Debrant/great_411_practicum/images/AHSmatrix.jpg

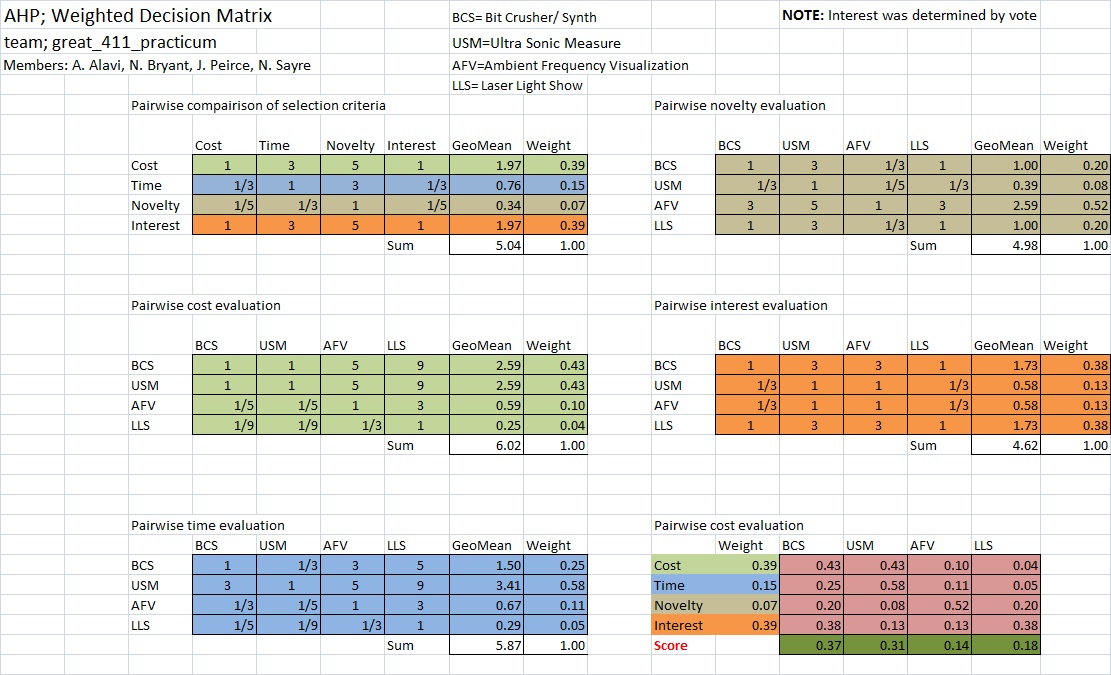
images/AHSmatrix.jpg
