Debrant/great_411_practicum/images/Relation_diagram.jpg

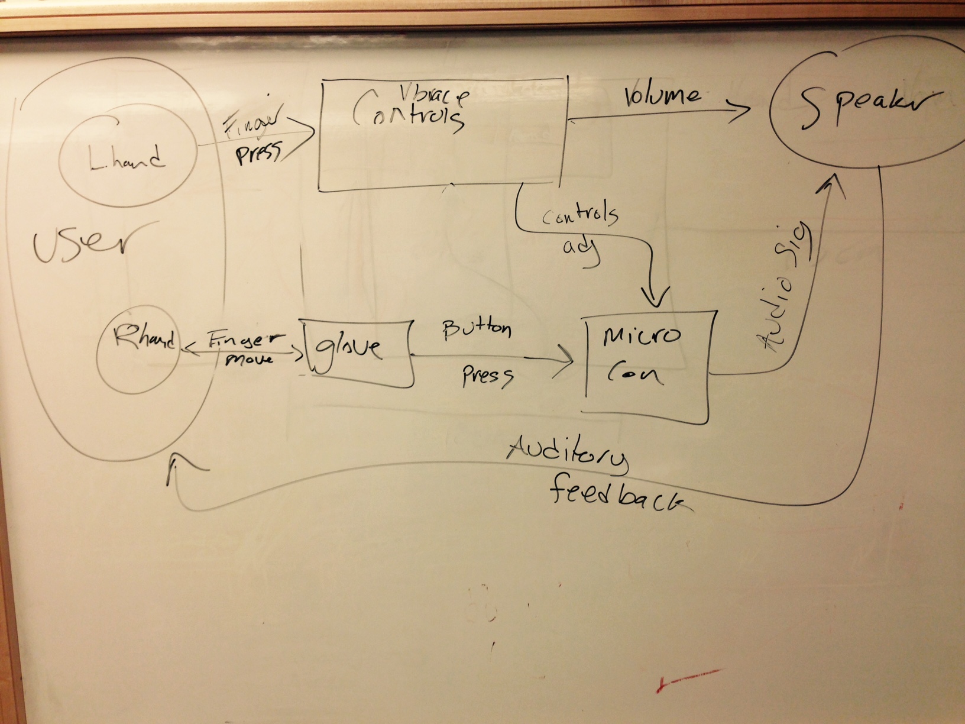
images/Relation_diagram.jpg
