Debrant/great_411_practicum/README.md

great_411_practicum
===================

Fall 2014 Industry Design Practicum at PSU

#[Project Wiki](https://github.com/Debrant/great_411_practicum/wiki)
