Debrant/great_411_practicum/pdfs/presentation.pdf

T01

# Synthesizer Glove

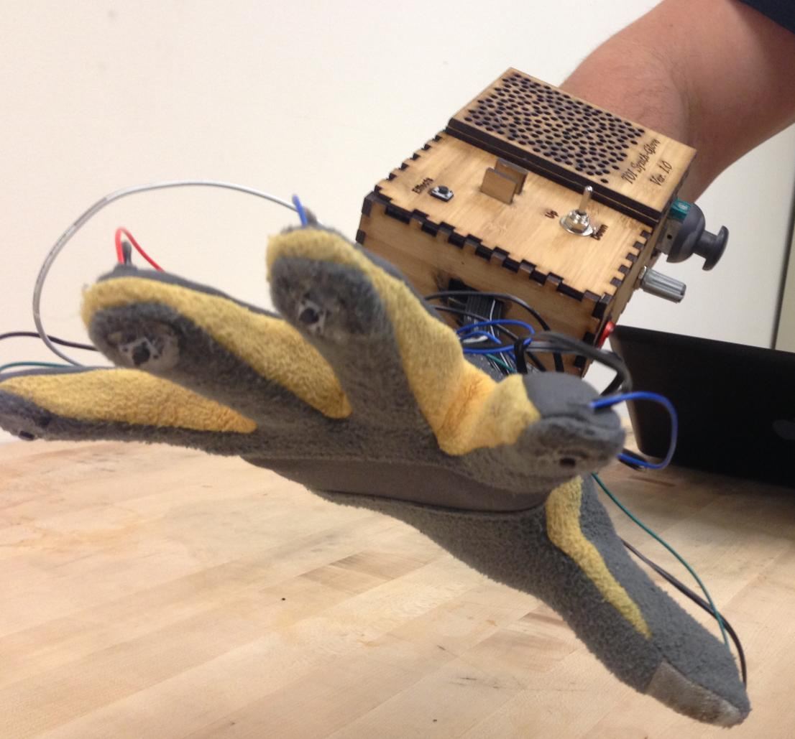
[picture p3: figure]

## Steve Peirce Nicholas Sayre Nathan Bryant Ali Alavi

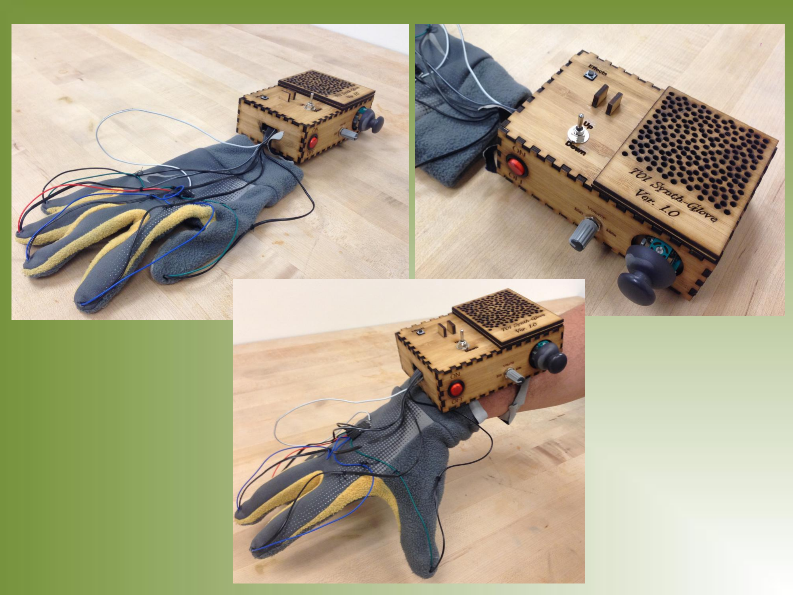
[picture p4: page 2]

# Motive

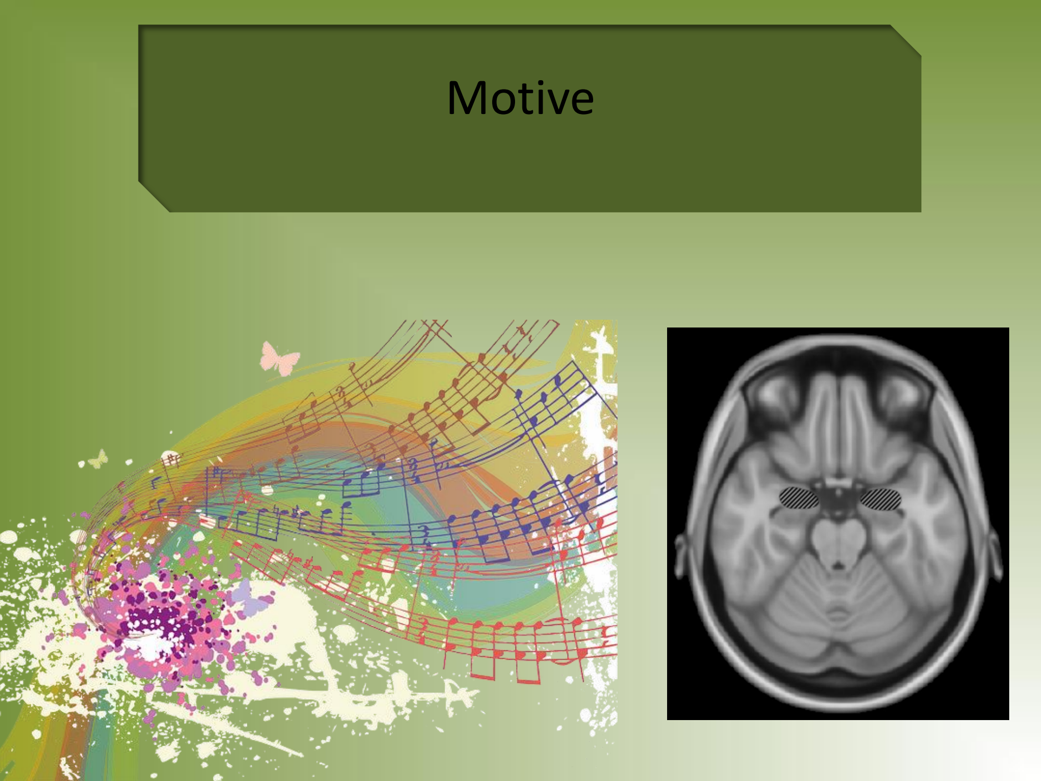
[picture p5: page 3]

# Goal

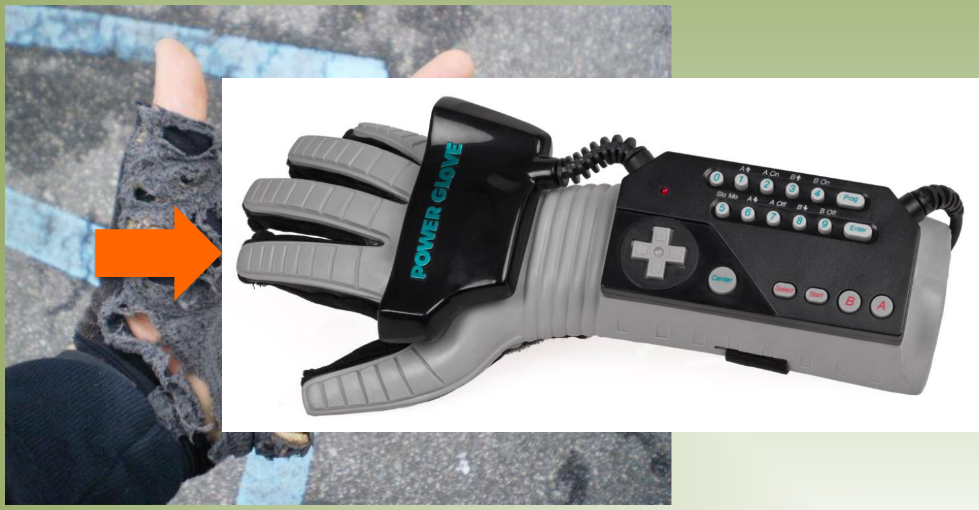
[picture p6: figure]

# Alternatives

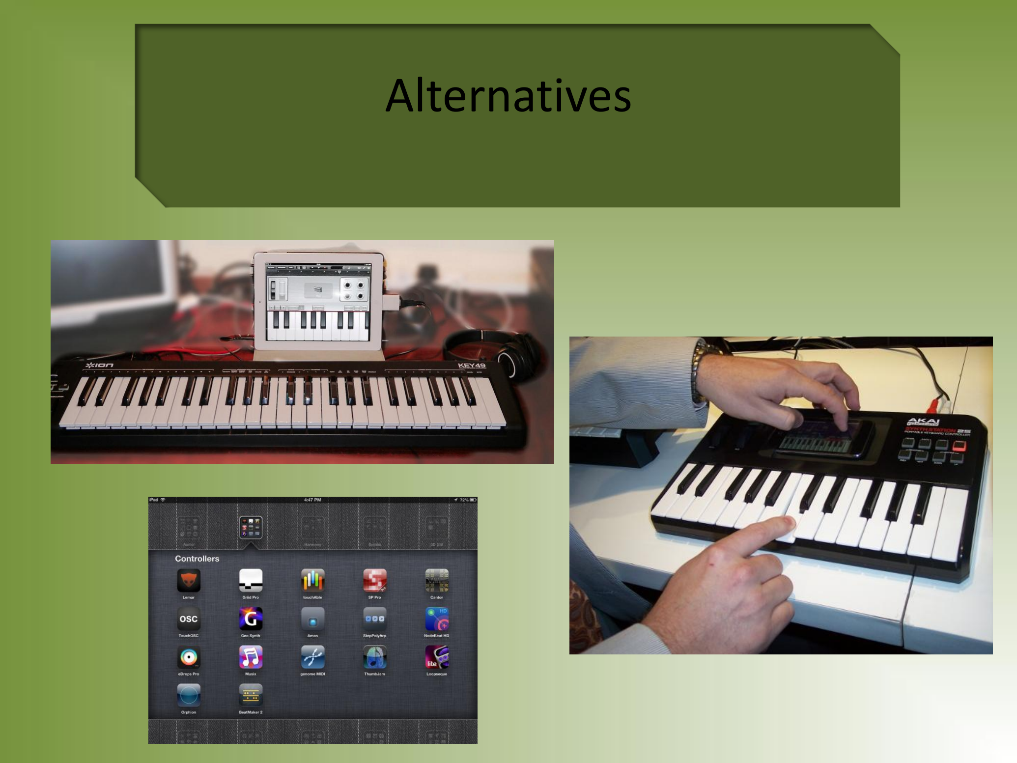
[picture p7: page 5]

# Approach

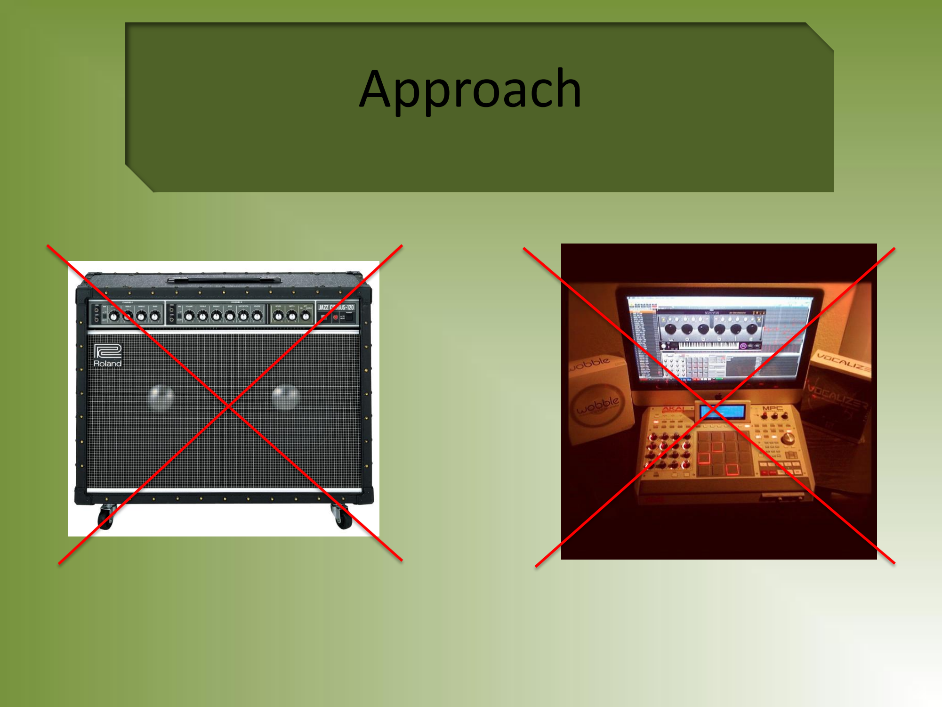
[picture p8: page 6]

# Requirements

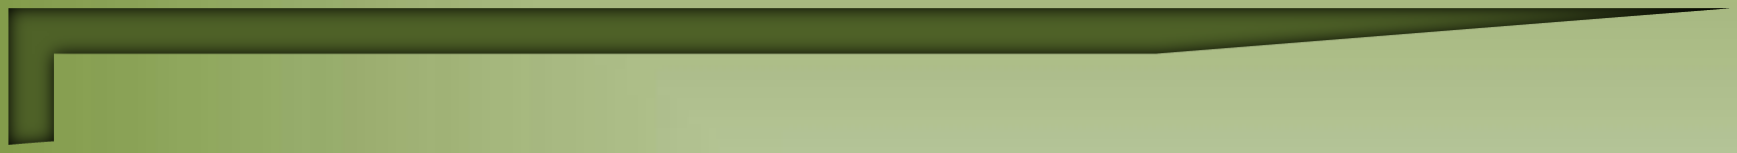
[picture p9: figure]

# System will be capable of producing tones

based on finger contact.

# System will be capable of producing a

minimum of 5 frequencies.

# System will be capable of altering the produced tones based on the status of at least two

sensors.

# The system will use an inexpensive cost microcontroller to produce low resolution

sounds.

# System must be wearable on users hand or

forearm.

# System will be battery powered and have power consumption of approximately 2.5

watts.

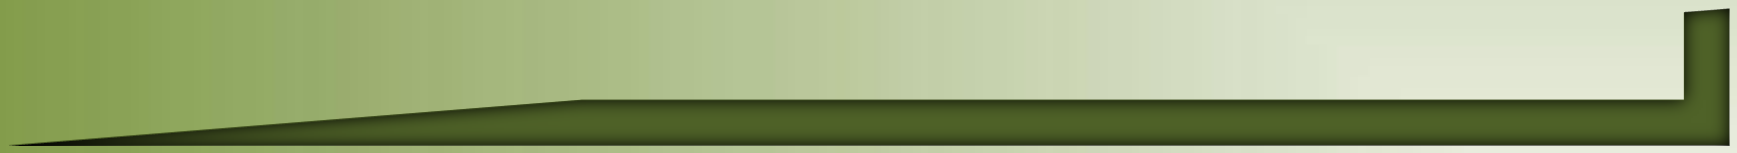
[picture p10: figure]

# Design Level 0

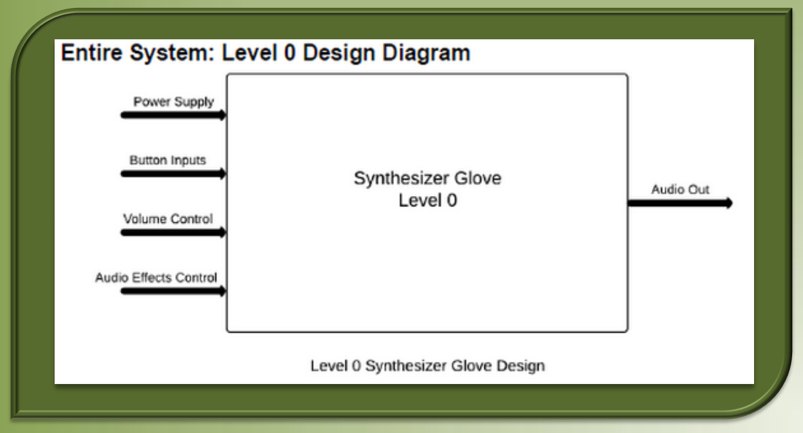
[picture p11: figure]

# Design Level 1

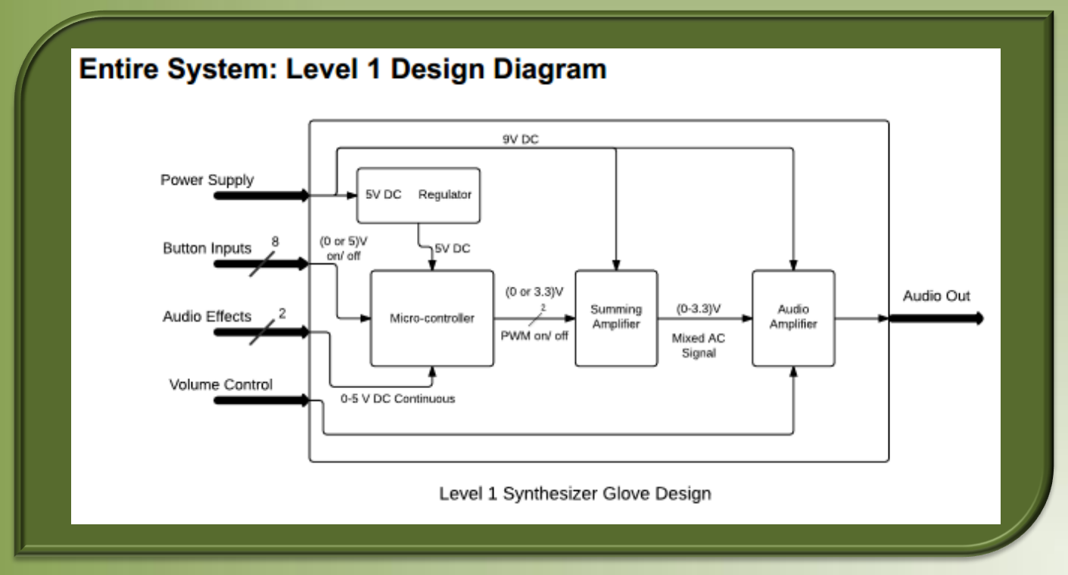
[picture p12: figure]

# Use Case

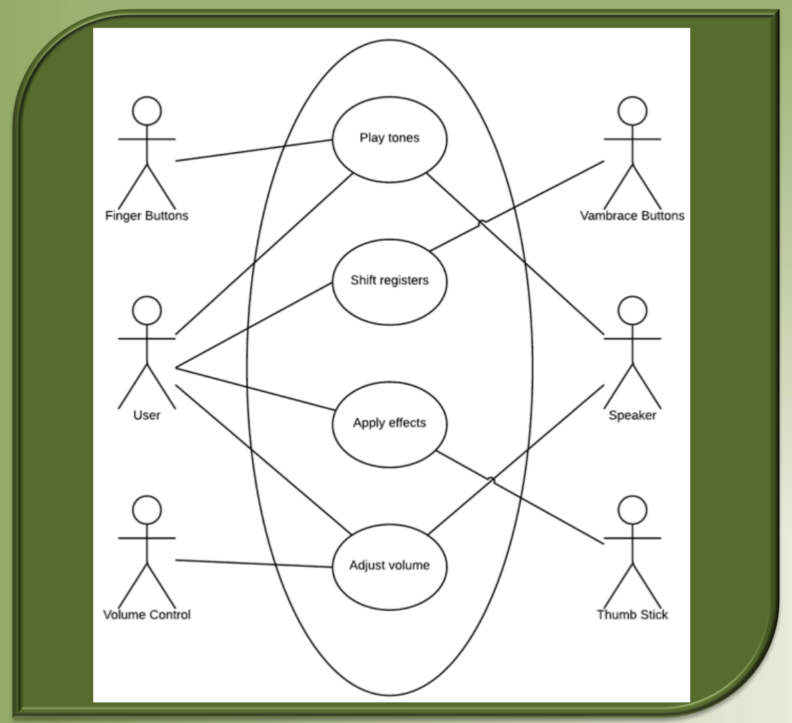
[picture p13: figure]

# Schematic

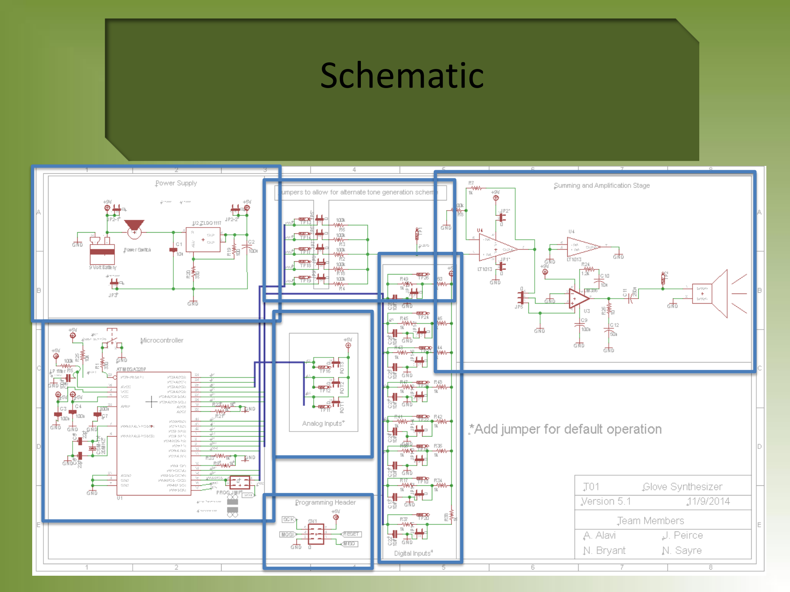
[picture p14: page 11]

# PCB Layout

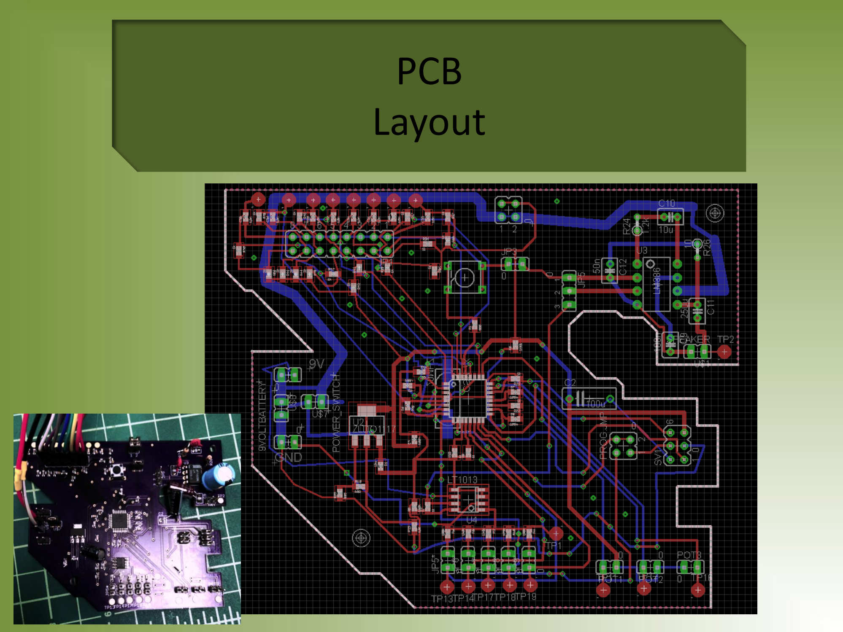
[picture p15: page 12]

# Programming

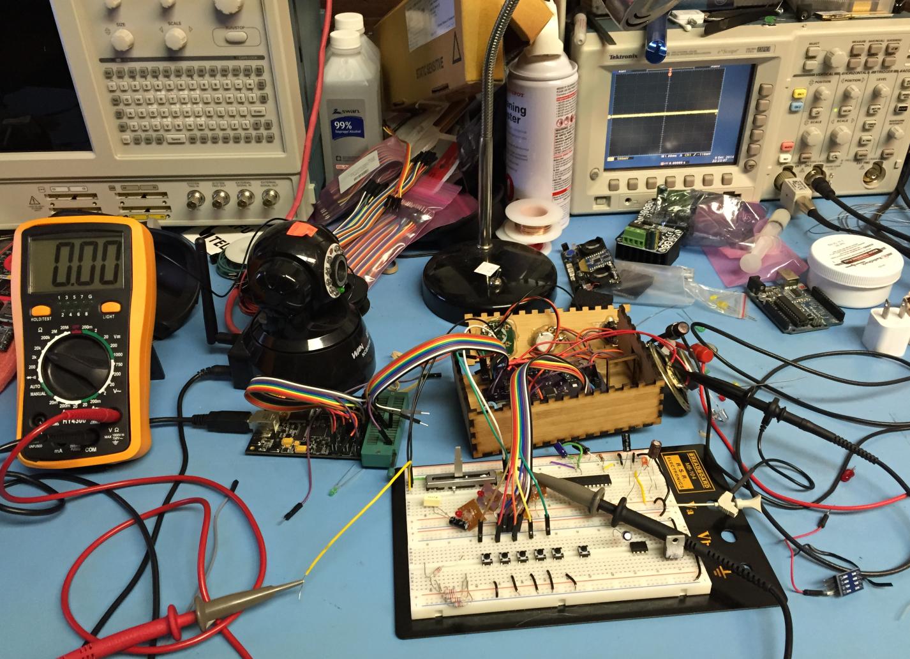
[picture p16: figure]

# Programming Testing

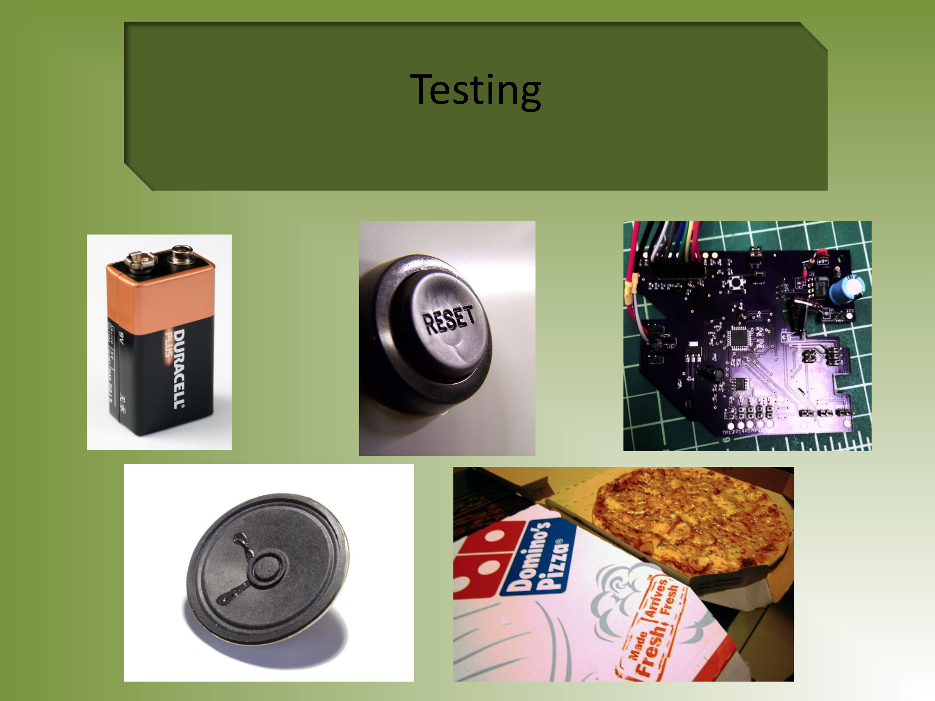
[picture p17: page 14]

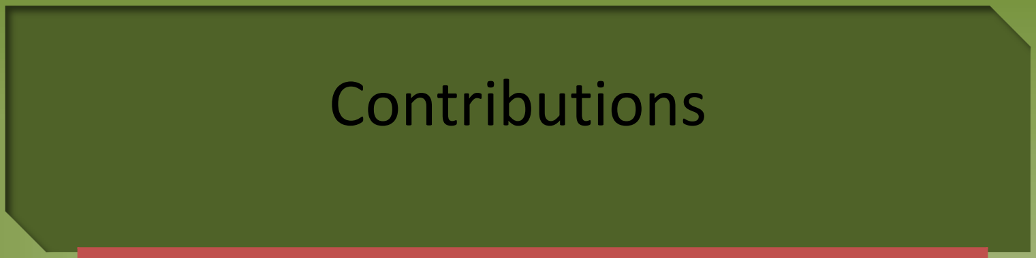
[picture p18: figure]
Contributions

Ali | Nathan | Nick | Steve
Research | Research | Research | Research
Proposal | Proposal | Proposal | Proposal
Design Requirements | Design Requirements | Design Requirements | Test Programs
Prototype Board Assembly | Schematic | Schematic | Write Program
Project Schedule Draft+Revise | PCB Layout | PCB Layout | Revise Program
System Diagrams | Project Schedule Review | Prototype Board Design and Assembly | Finalize Program
Housing | System Diagrams | System Diagrams | Testing
Prototype Assembly | Test Plan | Housing
Testing | Housing | PCB assembly
Presentation | PCB assembly | Prototype Assembly
| Prototype Assembly | Testing
| Testing

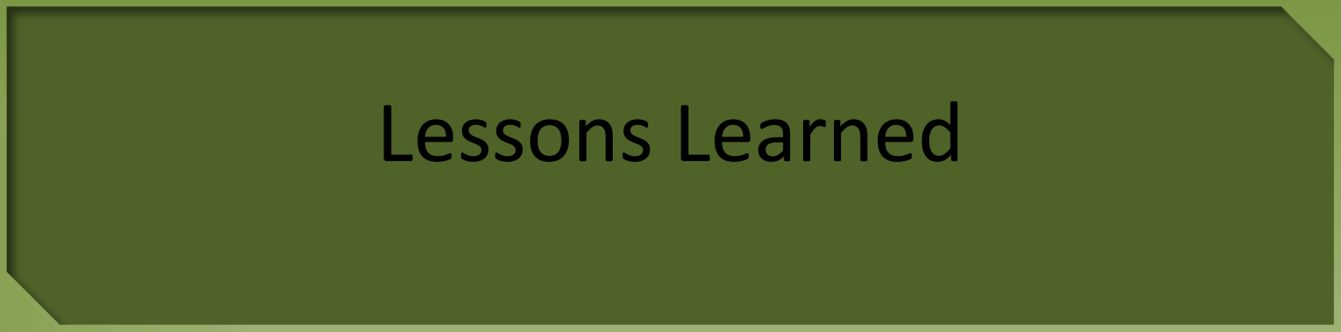
[picture p19: figure]
Lessons Learned

## - RULE OF 10!

-The ugly truth of Murphy's Law.

## -Eagle -Board layouts -Research research research! -Reading data sheets closely and repeatedly is key -Teamwork can be rough… -Stay ahead of schedule!

# Intellectual Property

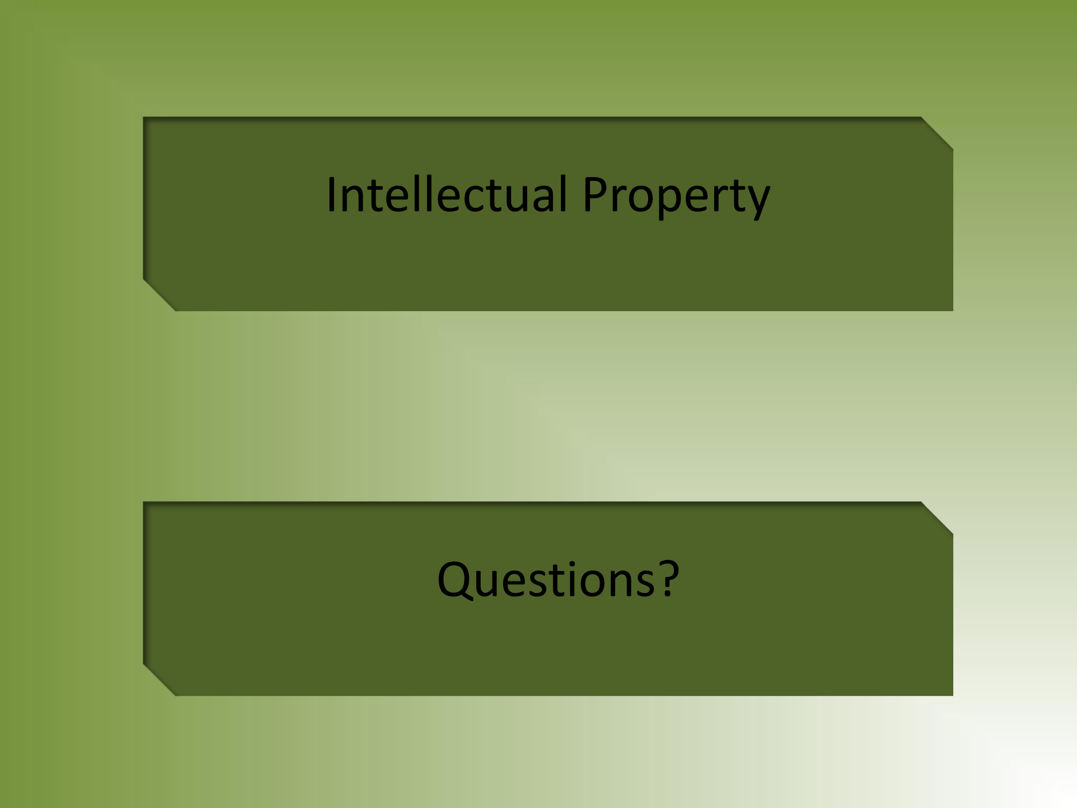
[picture p20: page 17]

# Questions?
