Debrant/great_411_practicum/pdfs/JRC 2073 low voltage audio amplifier.pdf

# NJM2073

# MEMO

[CAUTION]
The specifications on this databook are only given for information , without any guarantee as regards either mistakes or omissions. The application circuits in this databook are described only to show representative usages of the product and not intended for the guarantee or permission of any right including the industrial rights.
