Debrant/great_411_practicum/Schedule/joj_sched1_short.pdf

ID | Task Name
0 | T01 Synthesizer Glove
1 | 1 Choose Project
6 | 2 Research
19 | 3 Project Proposal
25 | 4 Manage Project Wiki
26 | 5 Design Requirements
32 | 6 Preliminary Schematic
41 | 7 Wire glove with buttons
42 | 8 Preliminary Board Layout
S | T | T | S | F | W | M | S
Sep 28, '14 | Oct 12, '14 | Oct 26, '14

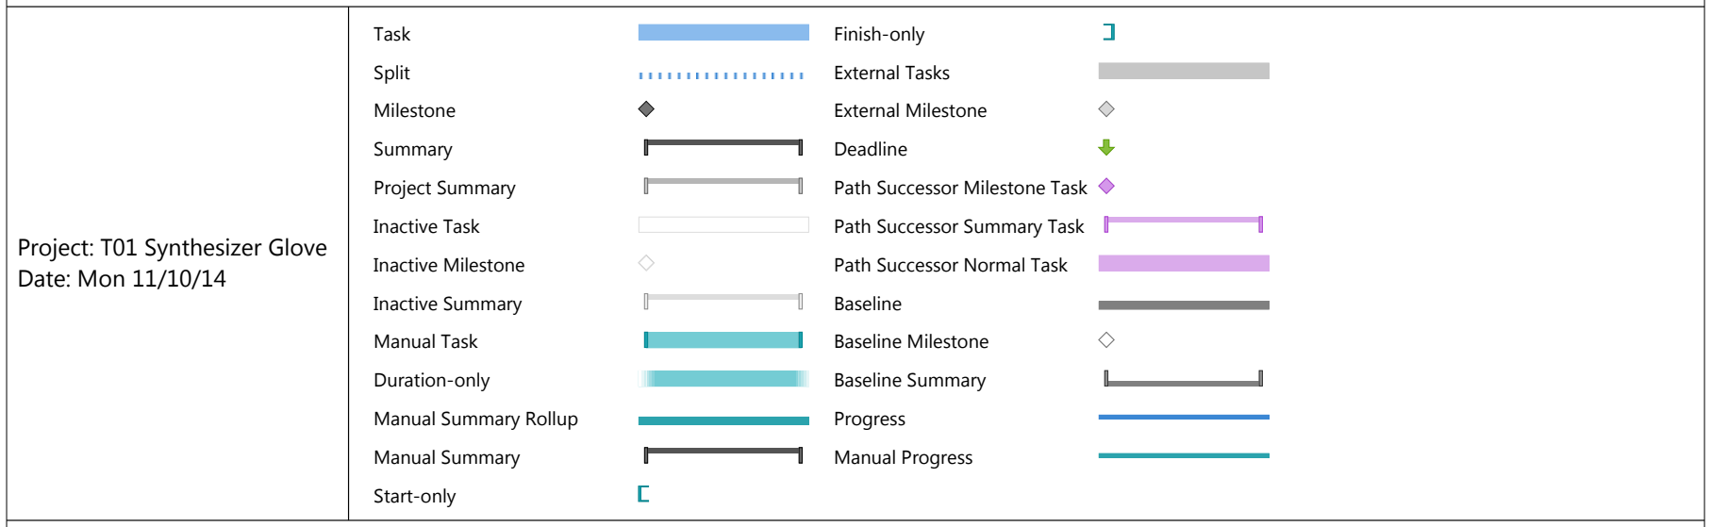
[picture p30: figure]
Task; Split; Milestone; Summary; Project Summary; Inactive Task; Inactive Milestone; Inactive Summary; Manual Task; Duration-only; Manual Summary Rollup; Manual Summary; Start-only; Finish-only; External Tasks; External Milestone; Deadline; Path Successor Milestone Task; Path Successor Summary Task; Path Successor Normal Task; Baseline; Baseline Milestone; Baseline Summary; Progress; Manual Progress; Project: T01 Synthesizer Glove Date: Mon 11/10/14

ID | Task Name
49 | 9 Prototype Board
58 | 10 Project Schedule
66 | 11 Send PCB files to vendor
73 | 12 System Diagram
81 | 13 Program Microcontroller
92 | 14 Test Plan
96 | 15 Build Housing
99 | 16 Working Prototype
112 | 17 Demo
S | T | T | S | F | W | M | S
Sep 28, '14 | Oct 12, '14 | Oct 26, '14

### Nathan,Nicholas,Ali

### Nathan,Nicholas,Steve

S | T | T | S | F | W | M | S | T | T | S | F | W
Oct 26, '14 | Nov 9, '14 | Nov 23, '14 | Dec 7, '14 | Dec 21, '14

12/8

S | T | T | S | F | W | M | S | T | T | S | F | W
Oct 26, '14 | Nov 9, '14 | Nov 23, '14 | Dec 7, '14 | Dec 21, '14
