Debrant/great_411_practicum/Case_plans/bl2.png

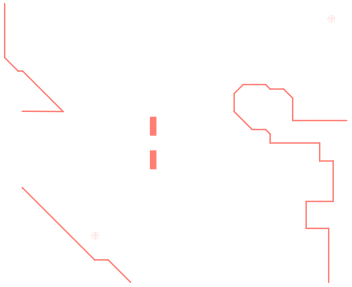
Case_plans/bl2.png
