Debrant/great_411_practicum/images/CompleteBoard.jpeg

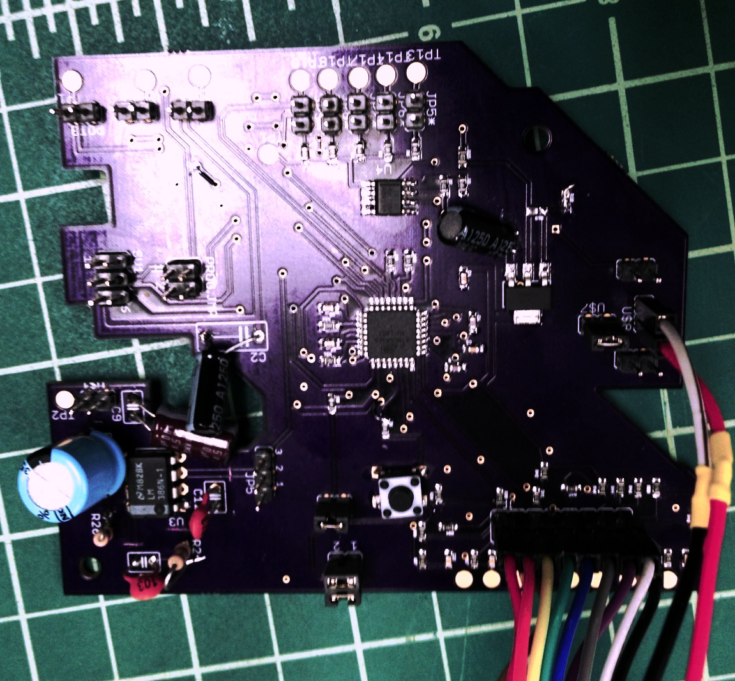
images/CompleteBoard.jpeg
