Debrant/great_411_practicum/images/FinalBRD.png

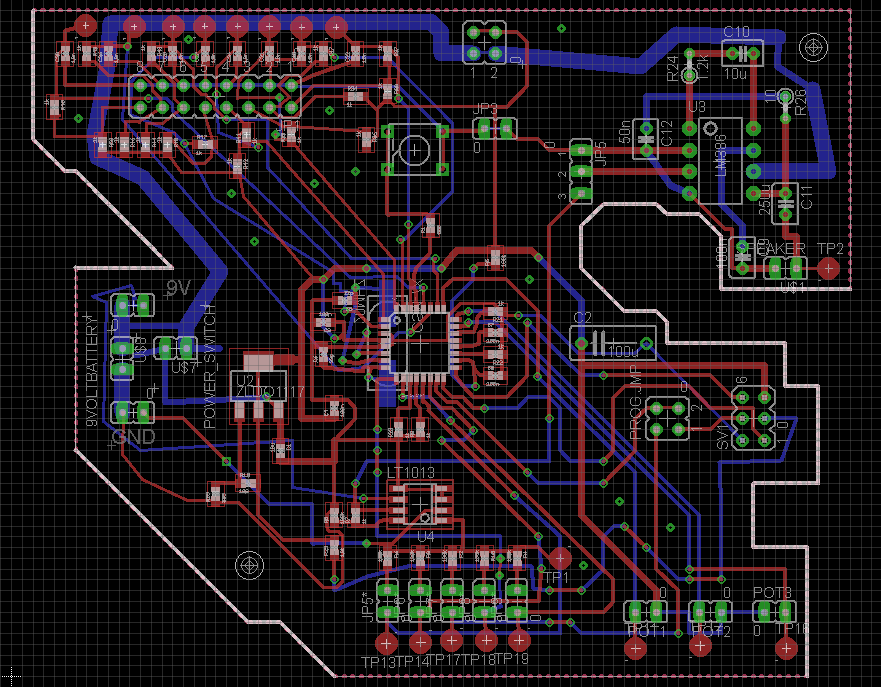
images/FinalBRD.png
