Debrant/great_411_practicum/images/FinalSCHM.png

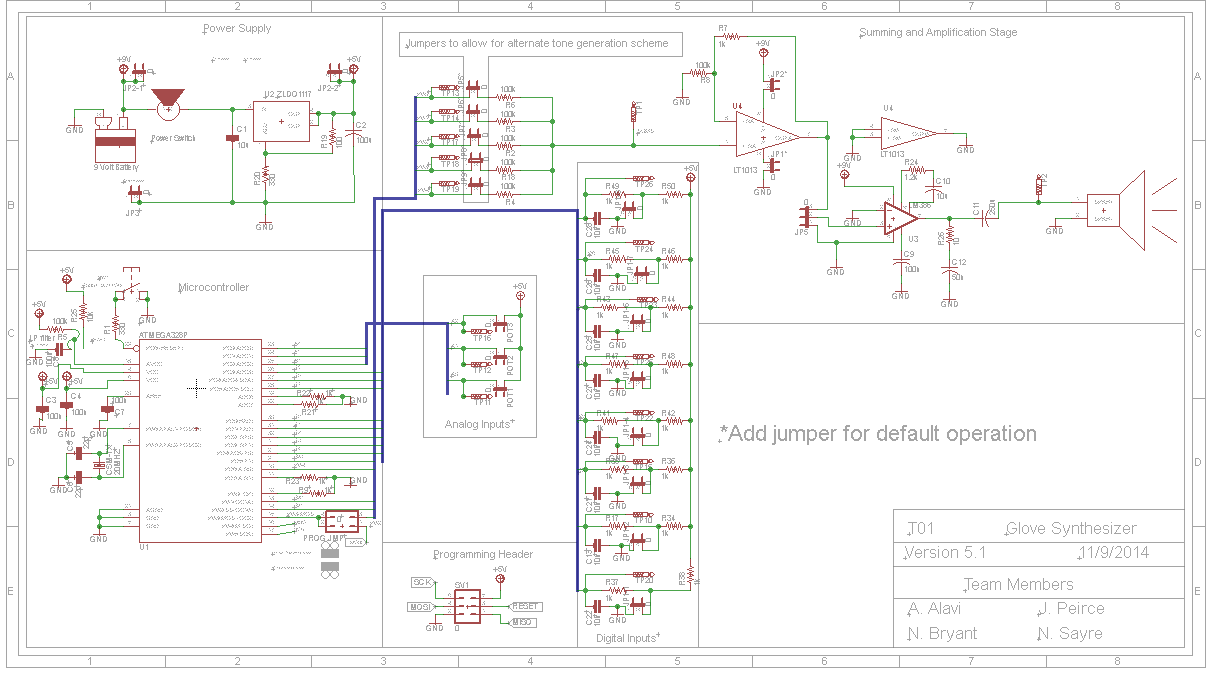
images/FinalSCHM.png
