Debrant/great_411_practicum/images/Fmap.gif

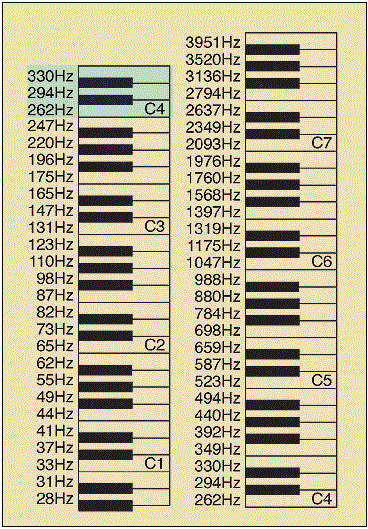
images/Fmap.gif
