Debrant/great_411_practicum/images/Lvl1_amps.jpg

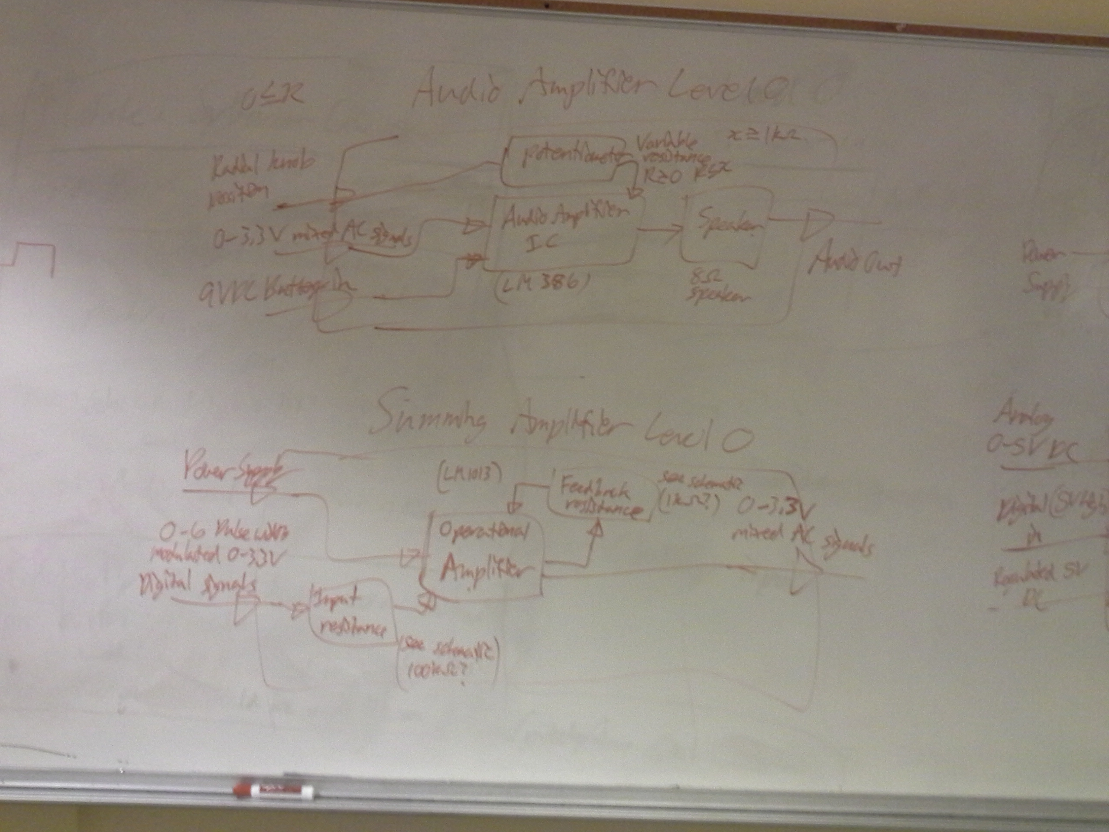
images/Lvl1_amps.jpg
