Debrant/great_411_practicum/images/Lvl1_system.jpg

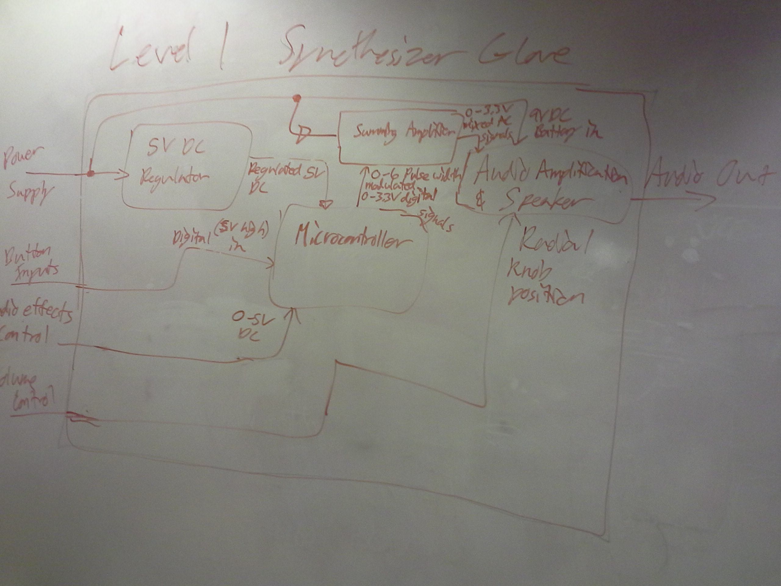
images/Lvl1_system.jpg
