Debrant/great_411_practicum/images/Lvl1_VR_MCU.jpg

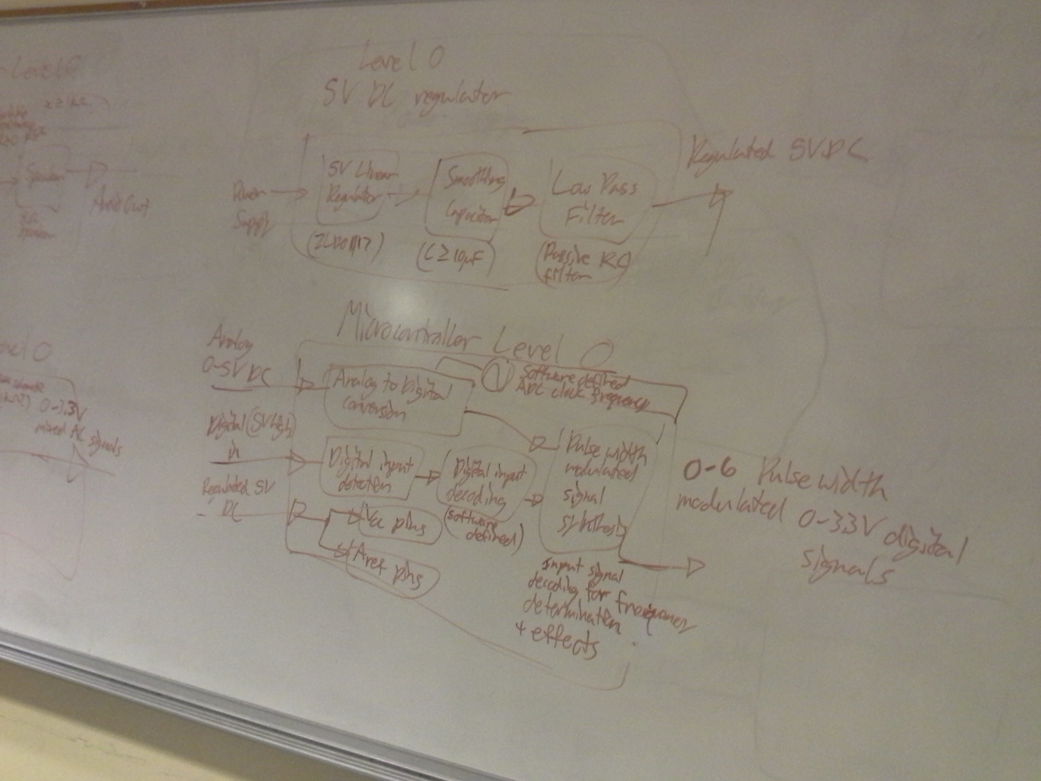
images/Lvl1_VR_MCU.jpg
