Debrant/great_411_practicum/images/meetnov9.JPG

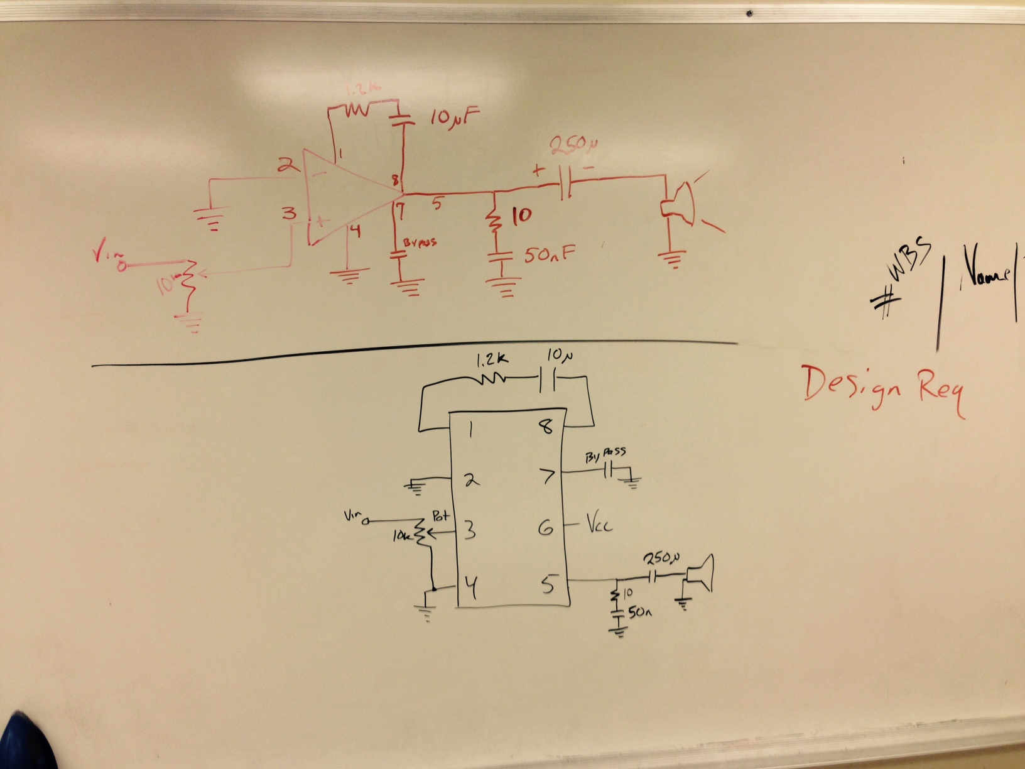
images/meetnov9.JPG
