Debrant/great_411_practicum/images/photo 1.JPG

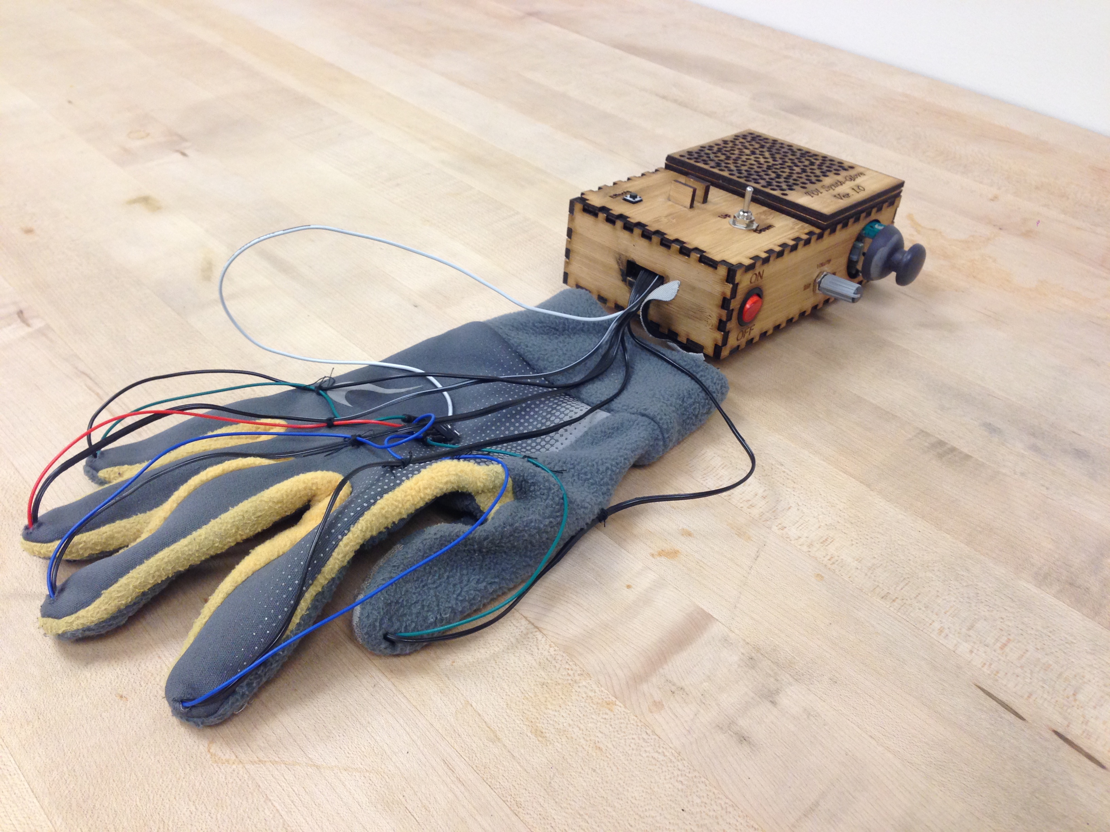
images/photo 1.JPG
