Debrant/great_411_practicum/images/photo 2.JPG

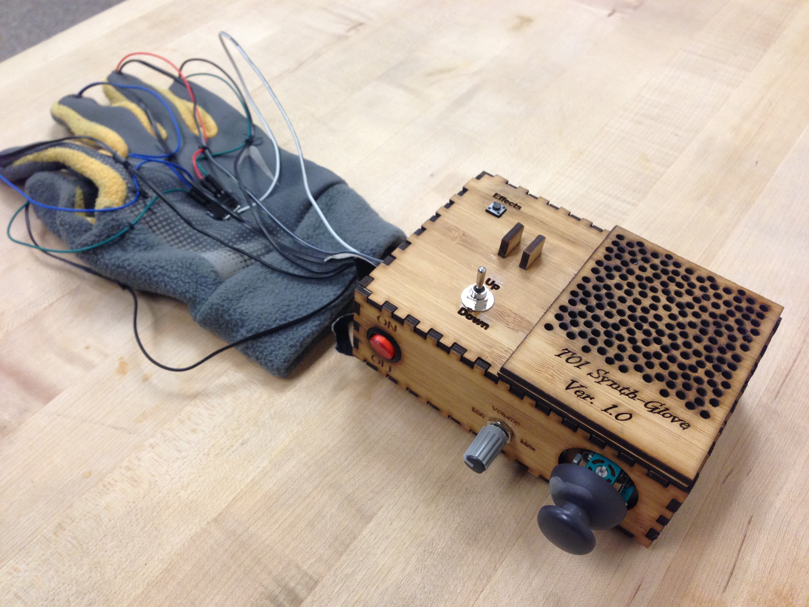
images/photo 2.JPG
