Debrant/great_411_practicum/images/photo 3.JPG

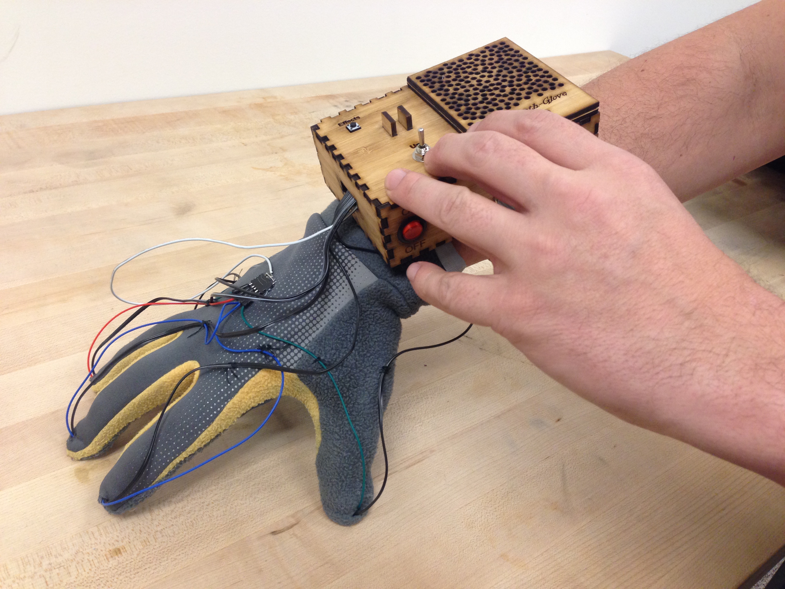
images/photo 3.JPG
