Debrant/great_411_practicum/images/photo 4.JPG

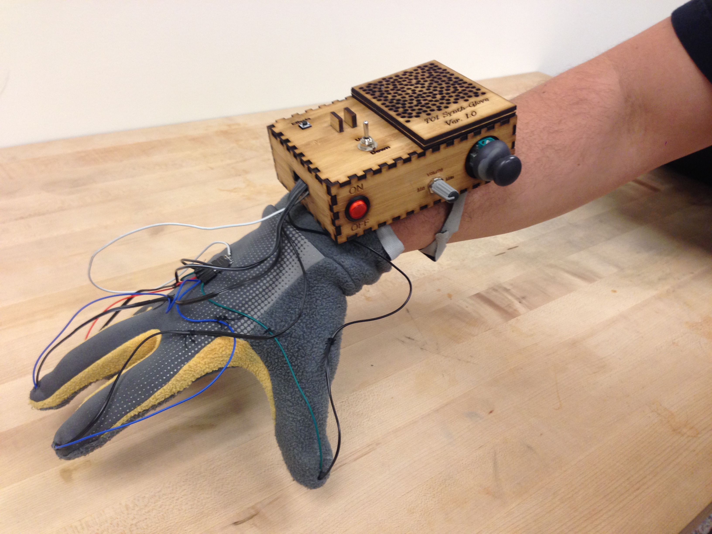
images/photo 4.JPG
