Debrant/great_411_practicum/images/photo 5.JPG

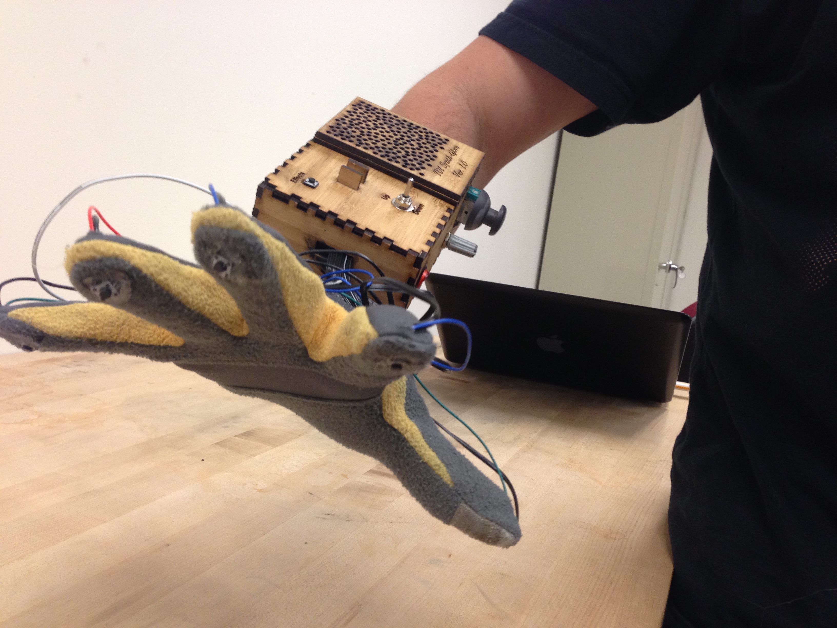
images/photo 5.JPG
