Debrant/great_411_practicum/images/prtotobrd.JPG

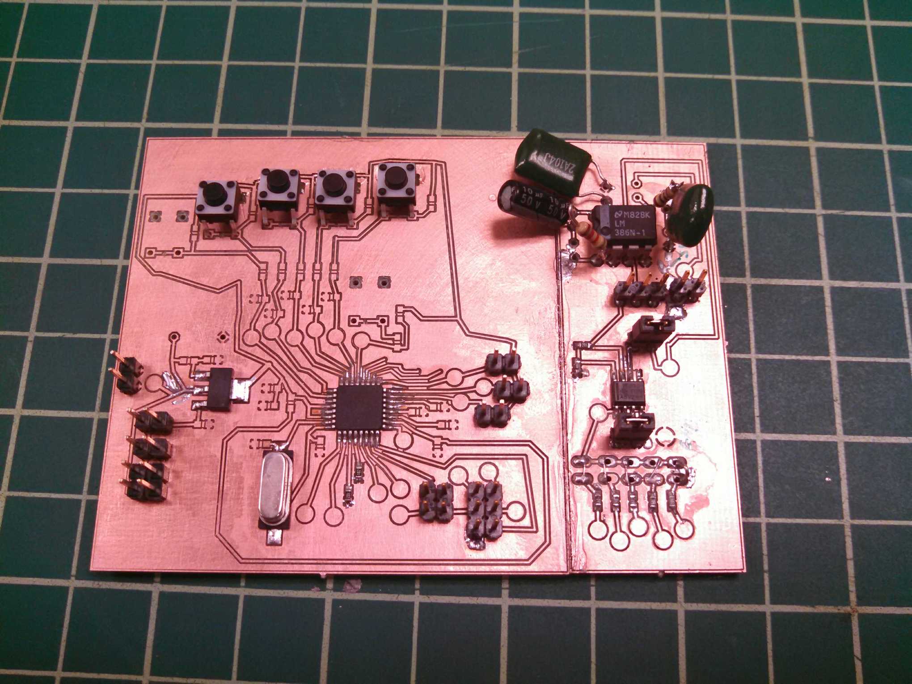
images/prtotobrd.JPG
