Debrant/great_411_practicum/images/side_enclusure.jpg

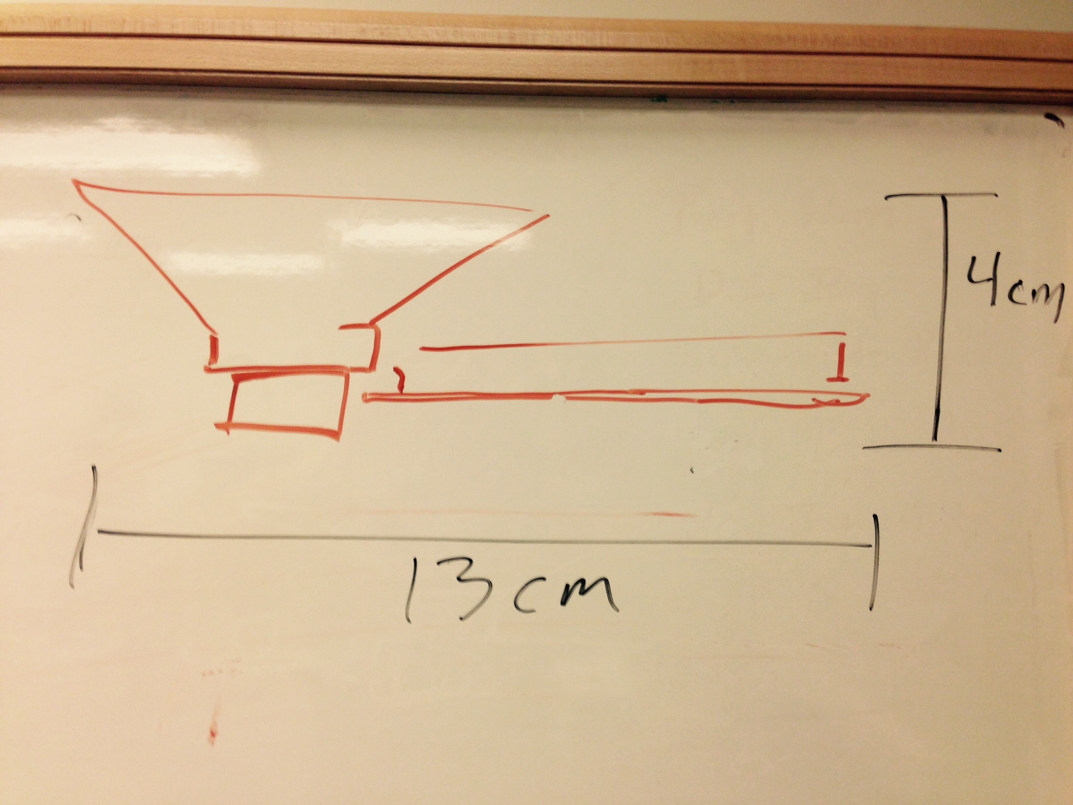
images/side_enclusure.jpg
