Debrant/great_411_practicum/images/state_diagram.jpg

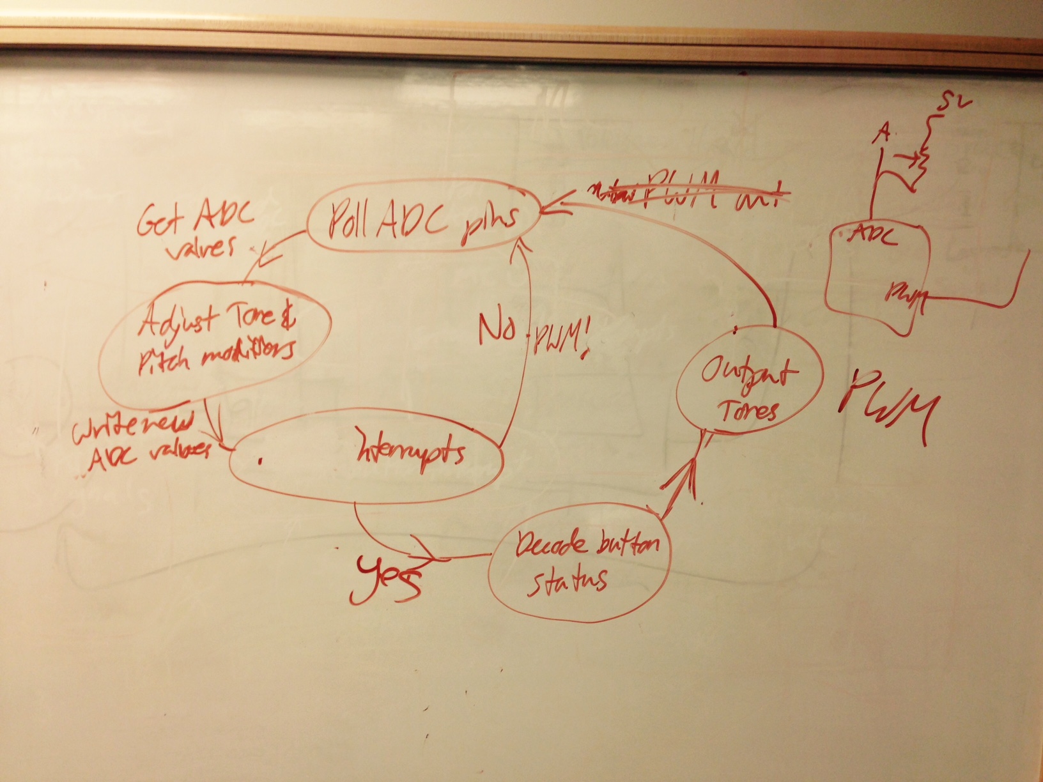
images/state_diagram.jpg
