Debrant/great_411_practicum/images/T01_meeting10.jpg

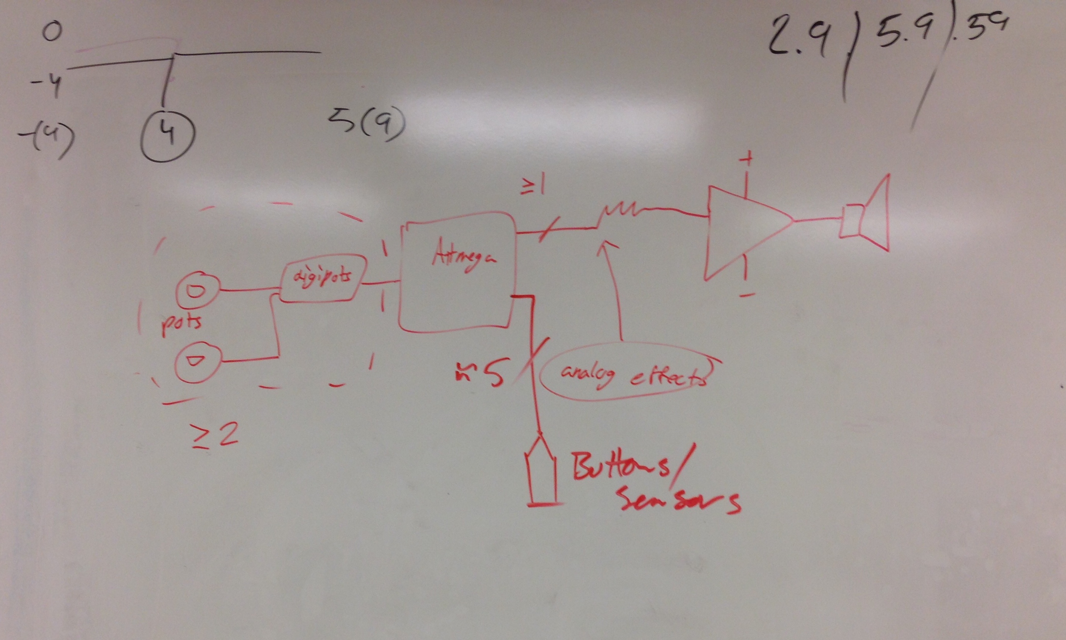
images/T01_meeting10.jpg
