Debrant/great_411_practicum/images/T01_PDS.png

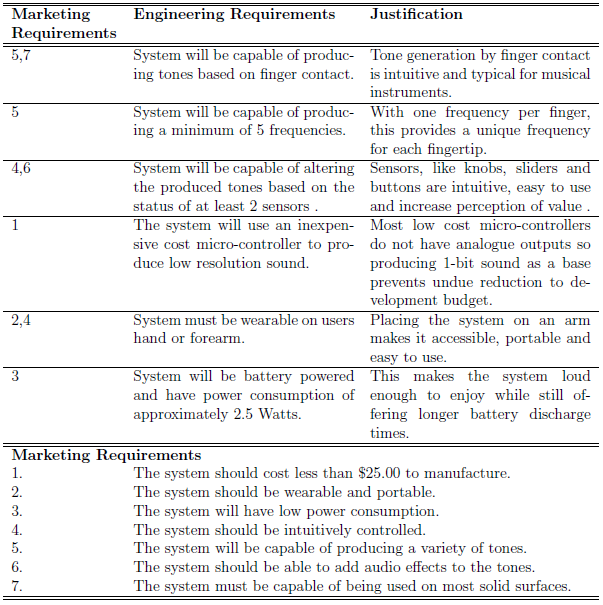
images/T01_PDS.png
