Debrant/great_411_practicum/images/T01_PDSv2.png

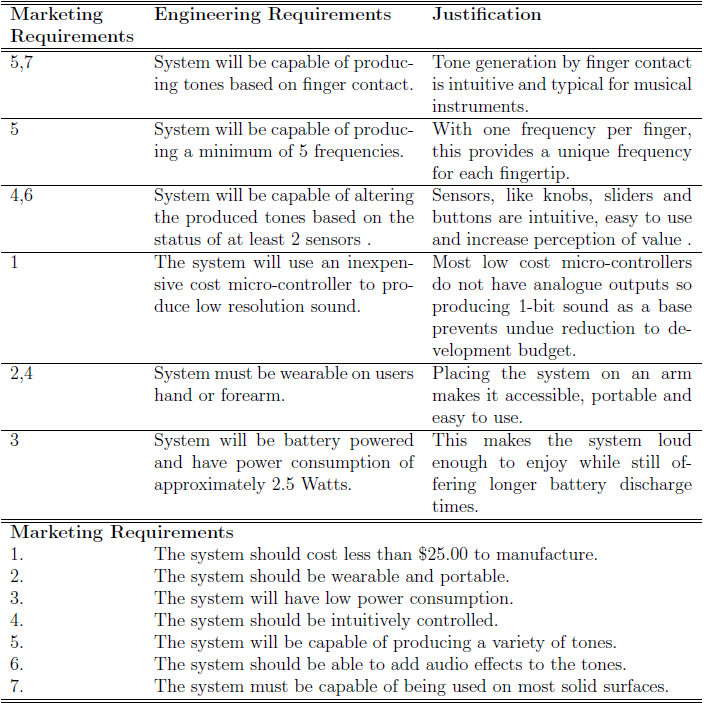
images/T01_PDSv2.png
