Debrant/great_411_practicum/images/top_enclosure.jpg

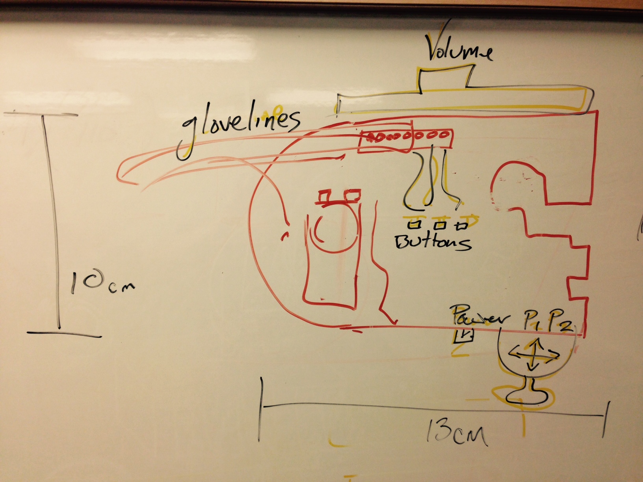
images/top_enclosure.jpg
