Debrant/great_411_practicum/images/umlpg1.png

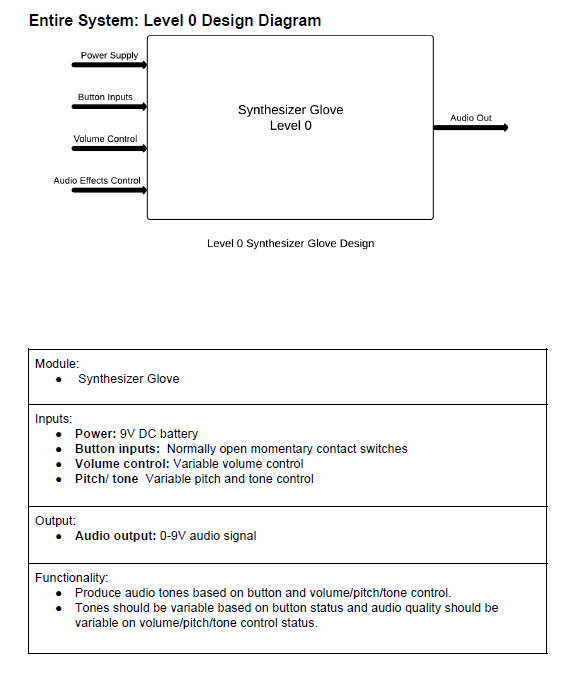
images/umlpg1.png
