Debrant/great_411_practicum/images/umlpg2.png

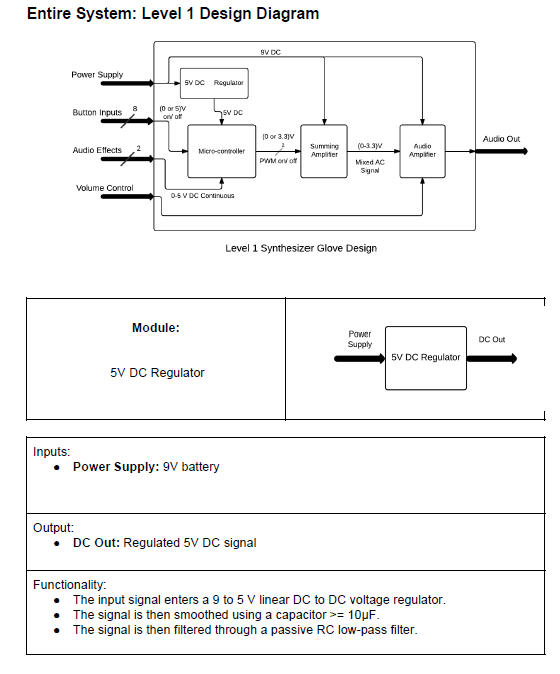
images/umlpg2.png
