Debrant/great_411_practicum/images/umlpg3.png

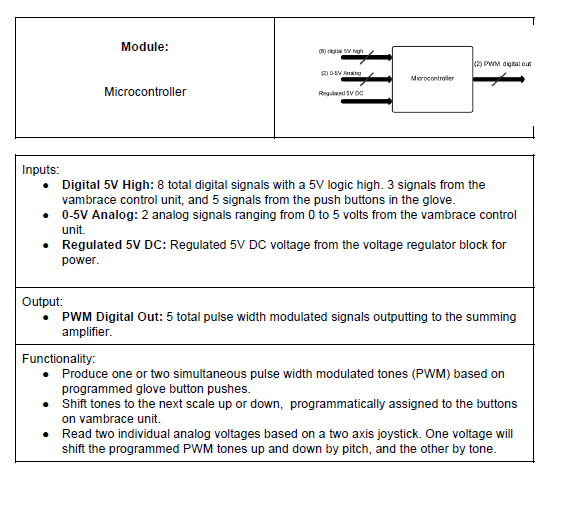
images/umlpg3.png
