Debrant/great_411_practicum/images/umlpg4.png

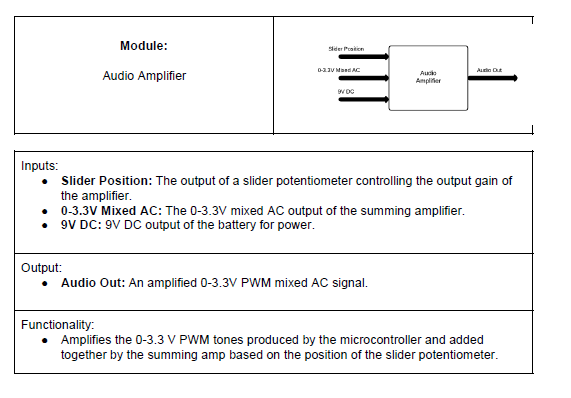
images/umlpg4.png
