Debrant/great_411_practicum/images/umlpg5.png

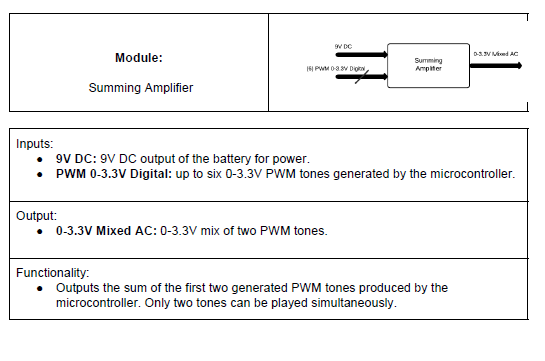
images/umlpg5.png
