Debrant/great_411_practicum/images/umlpg6.png

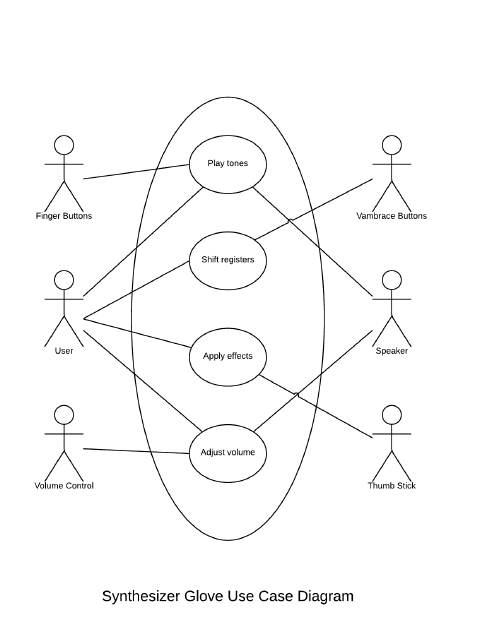
images/umlpg6.png
