Debrant/great_411_practicum/images/umlpg7.png

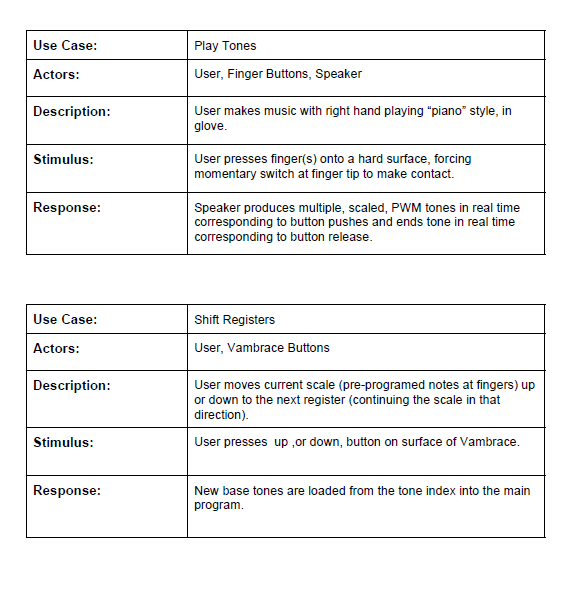
images/umlpg7.png
