Debrant/great_411_practicum/images/umlpg8.png

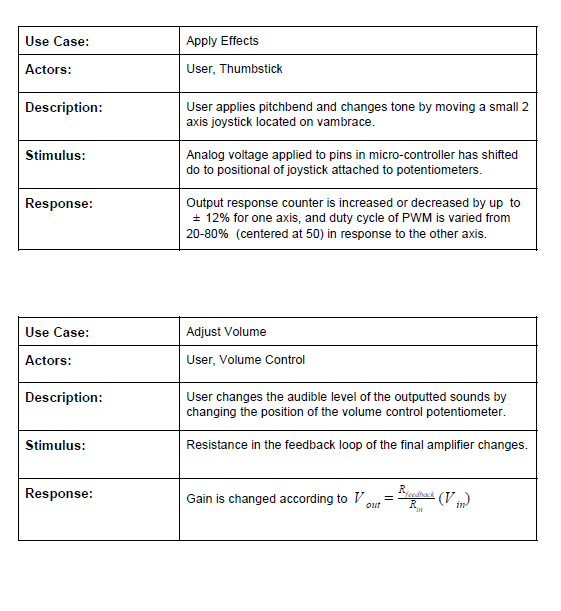
images/umlpg8.png
