Debrant/great_411_practicum/images/umlpg10.png

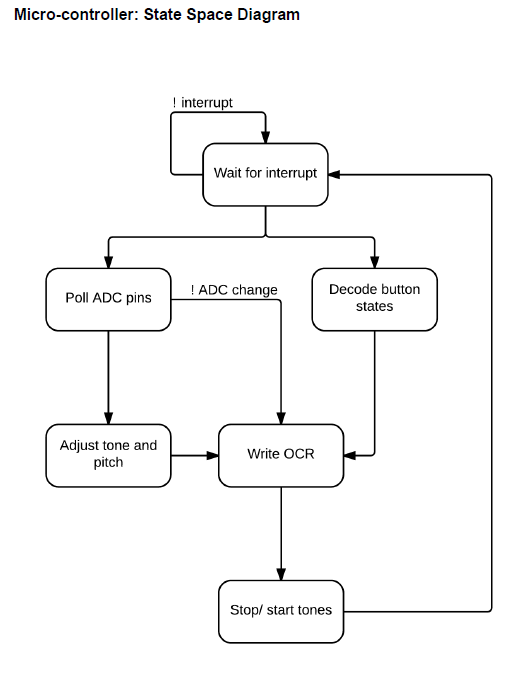
images/umlpg10.png
