Debrant/great_411_practicum/images/ZLDO114_outputvoltage.PNG

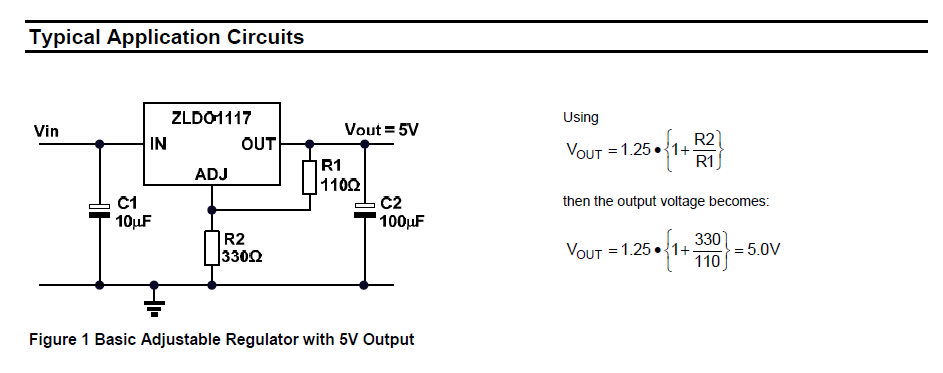
images/ZLDO114_outputvoltage.PNG
