Debrant/great_411_practicum/media/MeetN2.JPG

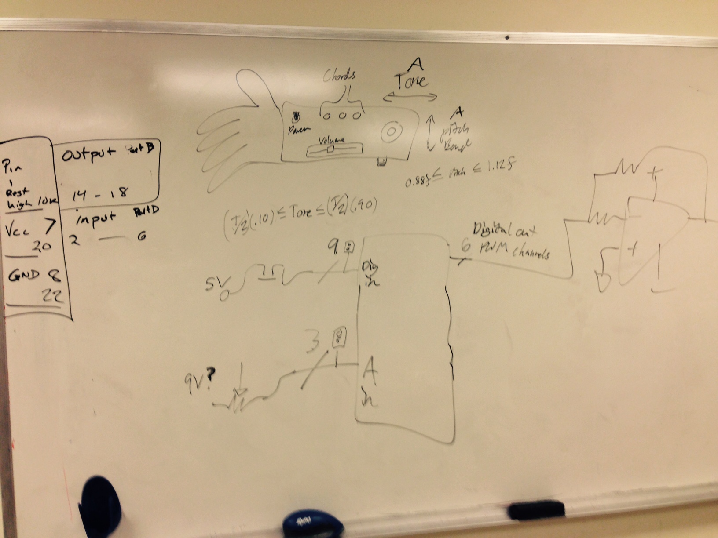
media/MeetN2.JPG
