Debrant/great_411_practicum/Schedule/joj_sched1_chart.pdf

ID | Task Name
1 | Choose Project
2 | Brainstorm Project Ideas
3 | Vote top 4 ideas
4 | Create Decision Matrix
5 | Final Decision
6 | Research
7 | Microcontroller
11 | Tone Generation
15 | Effects
18 | Investigate Cost
19 | Project Proposal
20 | Write Proposal Draft
21 | Review Draft
22 | Revise Draft
23 | Review Revision
24 | Submit Proposal
25 | Manage Project Wiki

Ali,Nicholas,Nathan,Steve

Ali,Nathan,Nicholas,Steve

Ali,Nathan,Nicholas,Steve

10/10

Ali,Nathan,Nicholas,Steve

Nathan

Ali,Nathan,Nicholas,Steve

Nathan,Nicholas

Ali,Nathan,Nicholas,Steve

10/13

Nathan,Nicholas,Ali

S | T | M | F | T | S | W | S | T | M | F | T | S | W | S | T | M | F | T | S | W | S
Sep 28, '14 | Oct 12, '14 | Oct 26, '14 | Nov 9, '14 | Nov 23, '14 | Dec 7, '14 | Dec 21, '14

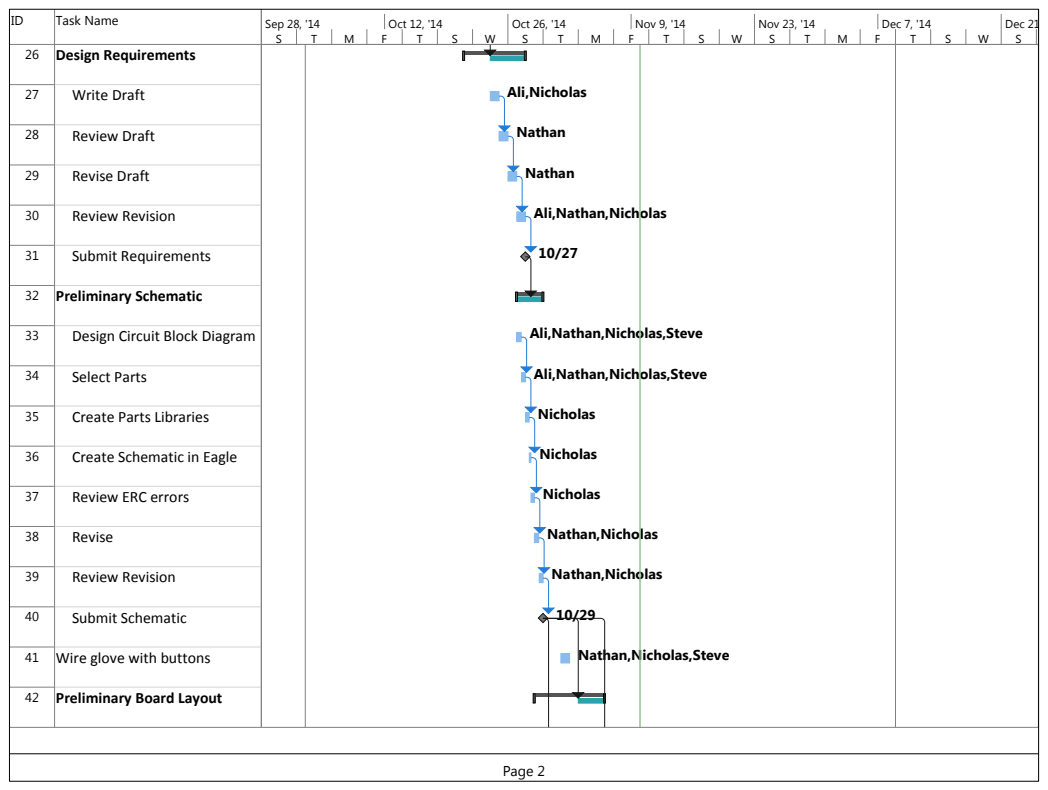
[picture p112: page 2]
Design Requirements; Write Draft; Review Draft; Revise Draft; Review Revision; Submit Requirements; Preliminary Schematic; Design Circuit Block Diagram; Select Parts; Create Parts Libraries; Create Schematic in Eagle; Review ERC errors; Revise; Submit Schematic; Wire glove with buttons; Preliminary Board Layout; Ali,Nicholas; Nathan; Nicholas; Nathan,Nicholas

Ali,Nathan,Nicholas

Ali,Nathan,Nicholas,Steve

Nathan,Nicholas,Steve

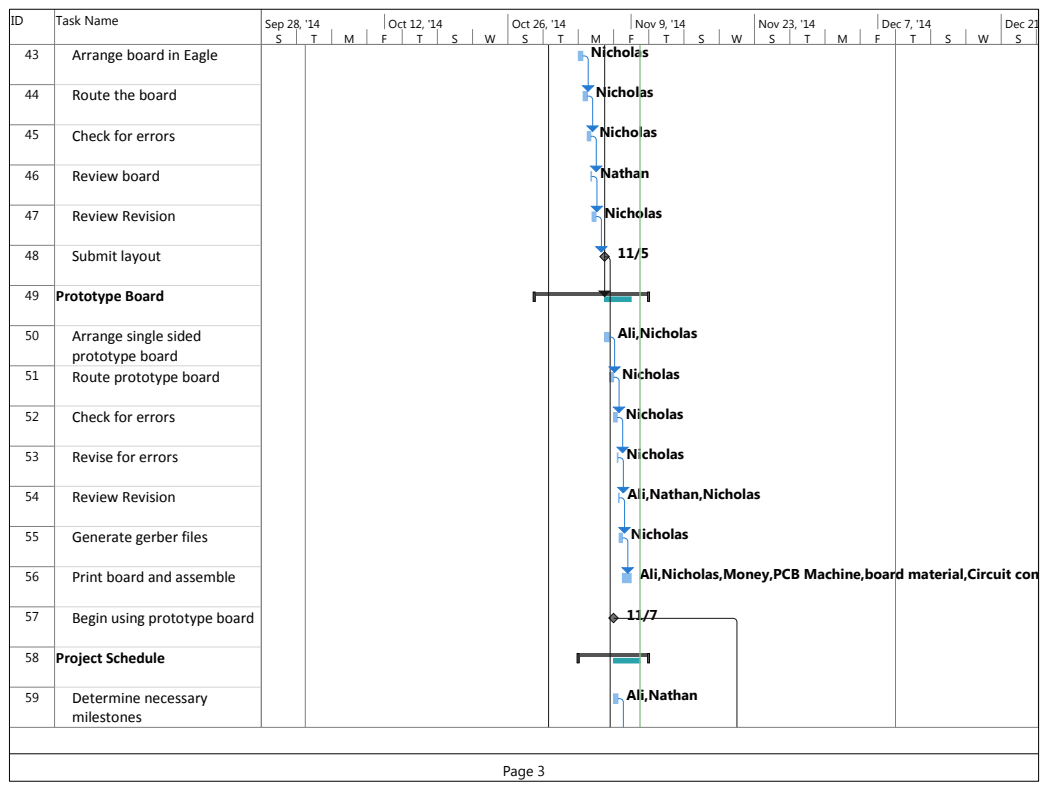
[picture p113: page 3]
Arrange board in Eagle; Route the board; Check for errors; Review board; Review Revision; Submit layout; Prototype Board; Arrange single sided; prototype board; Route prototype board; Revise for errors; Generate gerber files; Print board and assemble; Begin using prototype board; Project Schedule; Determine necessary; milestones; Nicholas; Nathan; Ali,Nicholas; Ali,Nathan

Ali,Nathan,Nicholas

Ali,Nicholas,Money,PCB Machine,board material,Circuit components

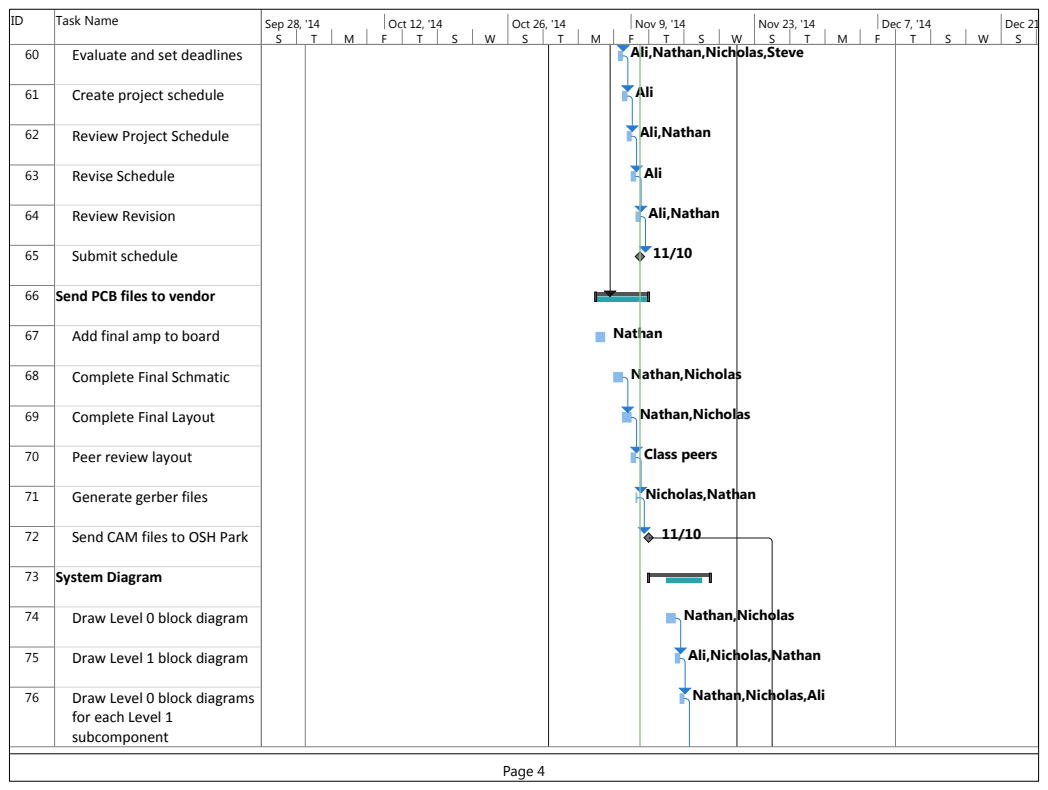
[picture p114: page 4]
Evaluate and set deadlines; Create project schedule; Review Project Schedule; Revise Schedule; Review Revision; Submit schedule; Send PCB files to vendor; Add final amp to board; Complete Final Schmatic; Complete Final Layout; Peer review layout; Generate gerber files; Send CAM files to OSH Park; System Diagram; Draw Level 0 block diagram; Draw Level 1 block diagram; Draw Level 0 block diagrams; Ali; Ali,Nathan; Nathan; Nathan,Nicholas; Class peers; Nicholas,Nathan

Ali,Nathan,Nicholas,Steve

Ali,Nicholas,Nathan

for each Level 1
subcomponent

Nathan,Nicholas,Ali

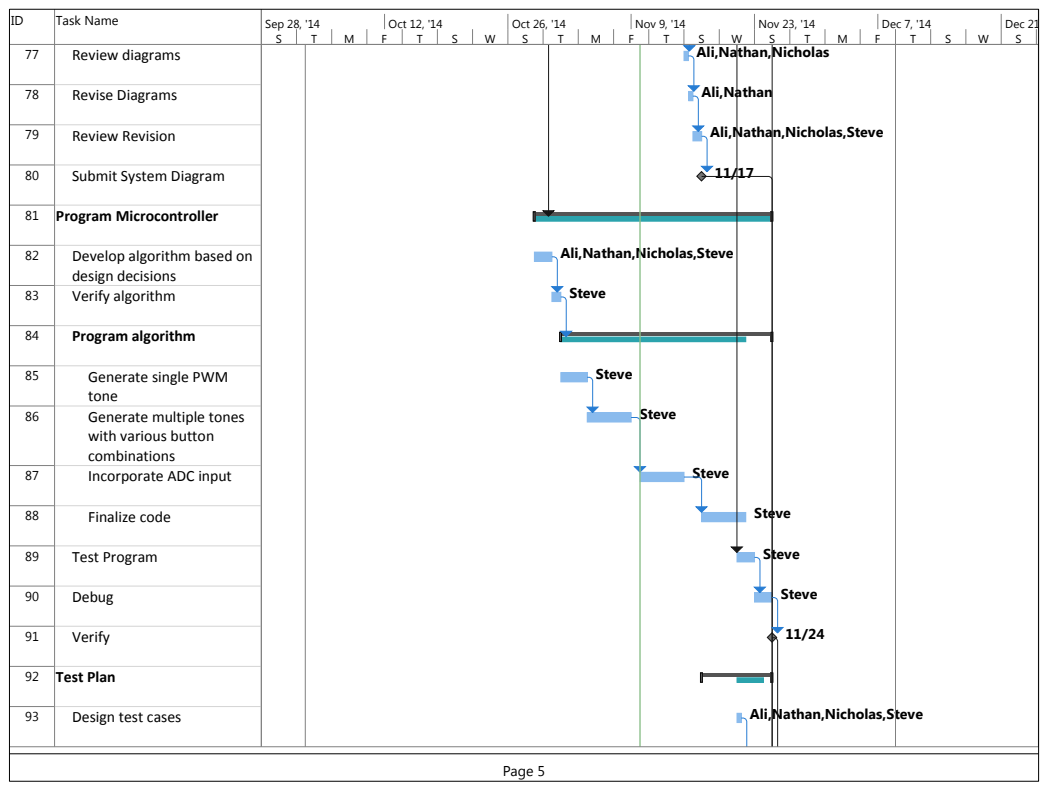
[picture p115: page 5]
Review diagrams; Revise Diagrams; Review Revision; Submit System Diagram; Program Microcontroller; Develop algorithm based on; design decisions; Verify algorithm; Program algorithm; Generate single PWM; tone; Generate multiple tones; Incorporate ADC input; Finalize code; Test Program; Debug; Verify; Test Plan; Design test cases; Ali,Nathan; Steve

Ali,Nathan,Nicholas

Ali,Nathan,Nicholas,Steve

with various button
combinations

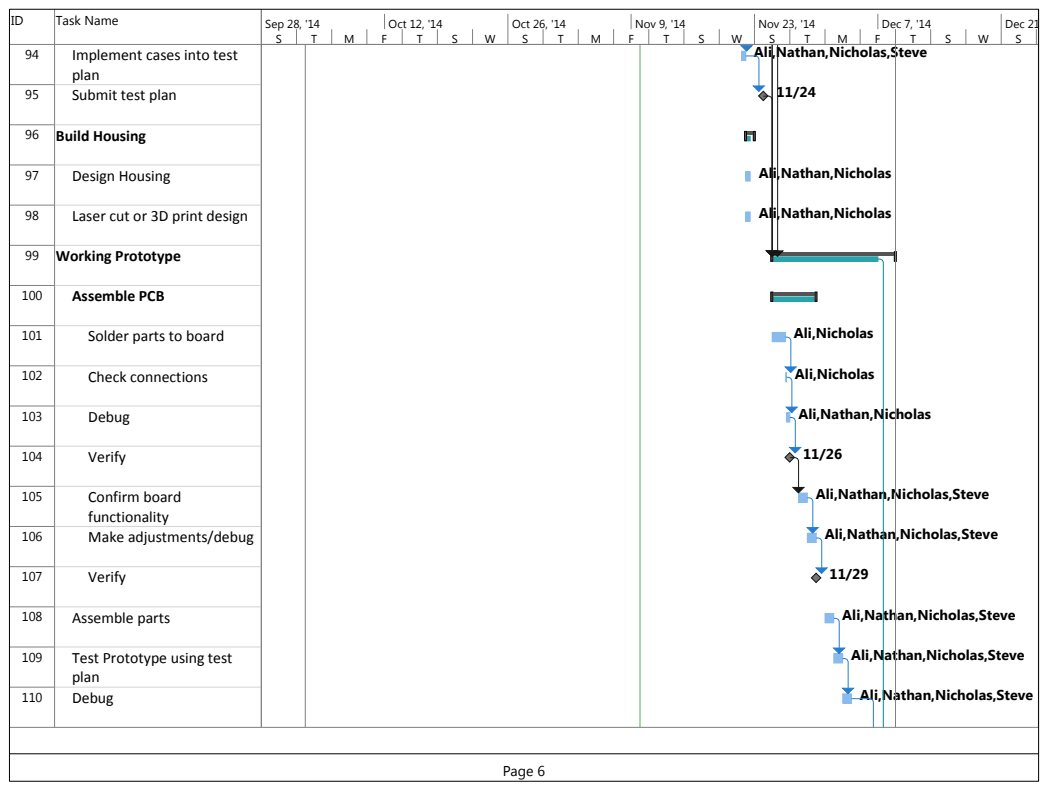
[picture p116: page 6]
Implement cases into test; plan; Submit test plan; Build Housing; Design Housing; Laser cut or 3D print design; Working Prototype; Assemble PCB; Solder parts to board; Check connections; Debug; Verify; Confirm board; functionality; Make adjustments/debug; Assemble parts; Test Prototype using test; Ali,Nicholas

Ali,Nathan,Nicholas,Steve

Ali,Nathan,Nicholas

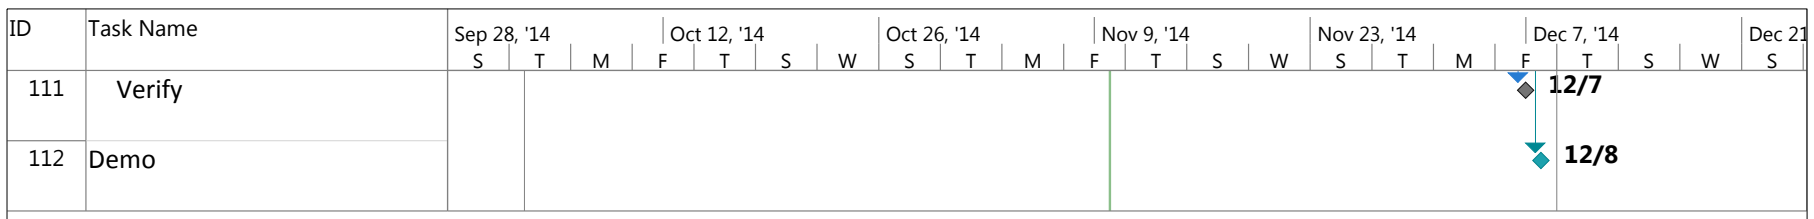
[picture p117: figure]
Verify; Demo
