Debrant/great_411_practicum/eagle/T01_Synth_Glove_Final.brd

## EAGLE design eagle/T01_Synth_Glove_Final.brd (2014-11-30)

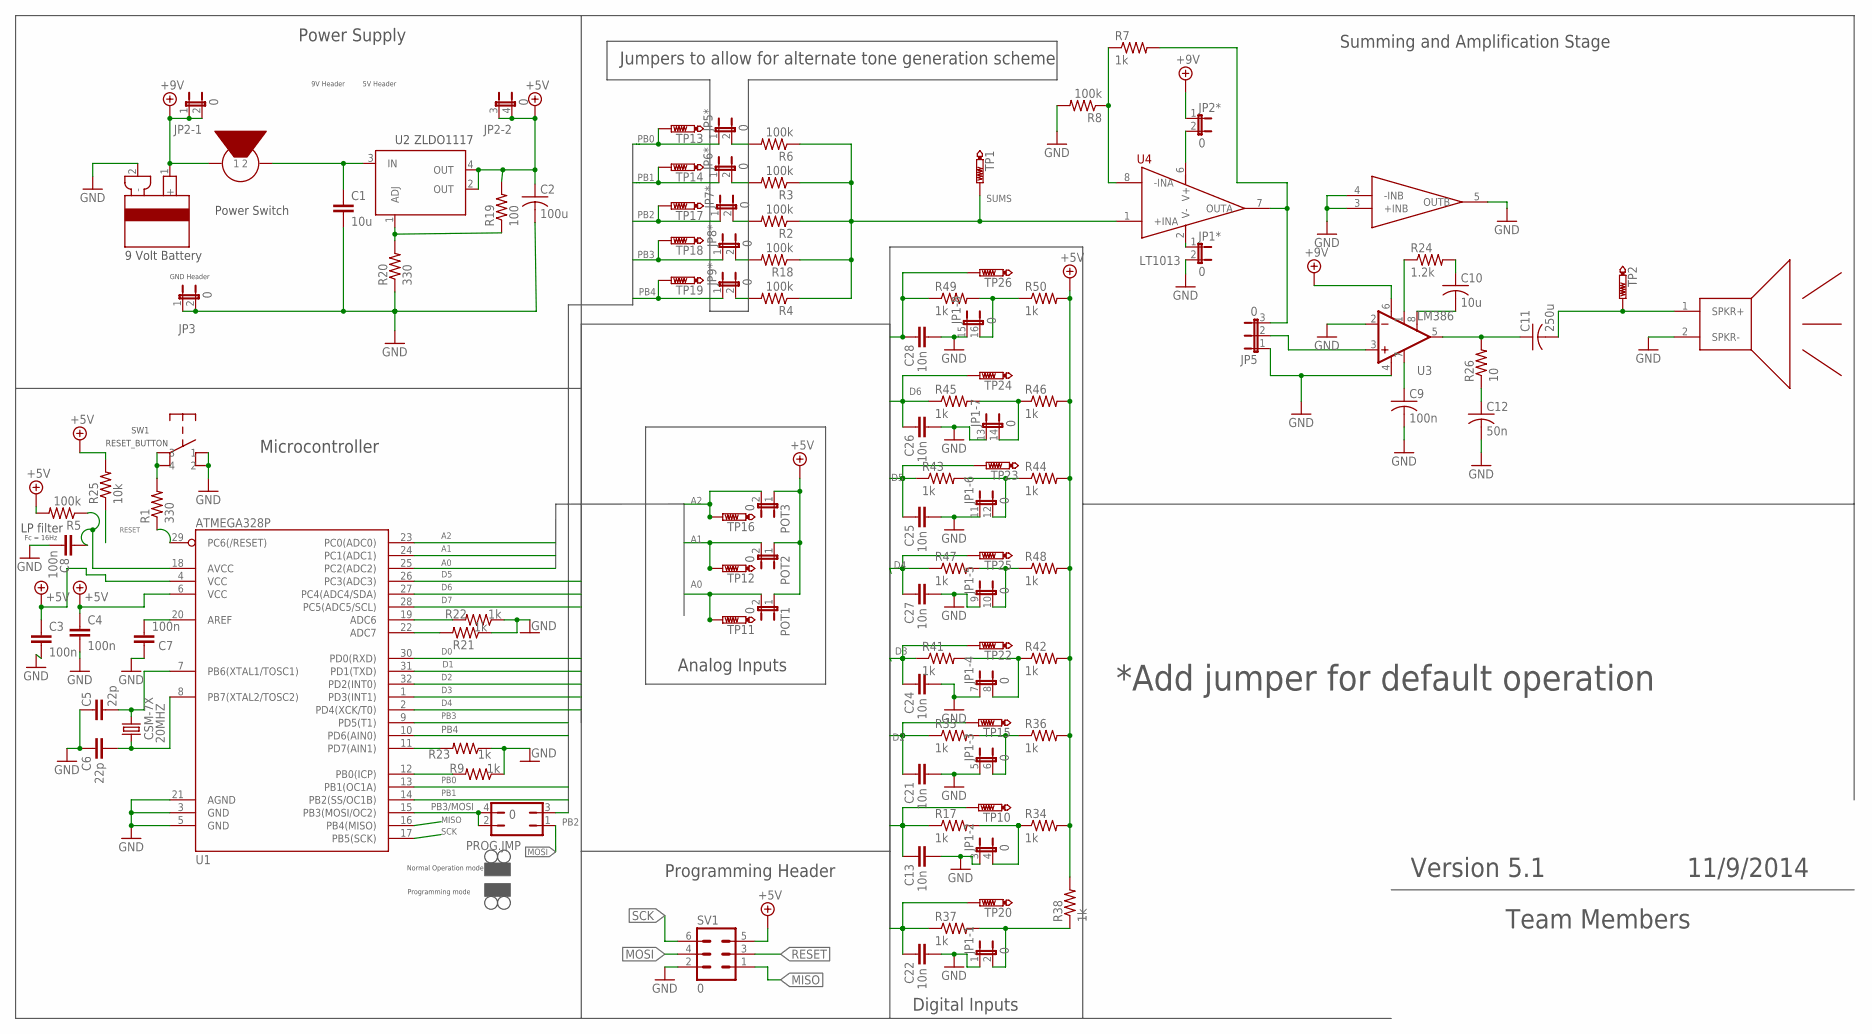
[picture p118: schematic T01_Synth_Glove_Final.sch, T01 Glove Synthesizer]

Parts:
20MHZ: CSM-7X; CSM-7X-DU
C1: 10u; 0603-CAP
C2: 100u; C075-042X103
C3, C4, C7, C8: 100n; 0603-CAP
C5, C6: 22p; 0603-CAP
C9: 100n; C025-030X050
C10: 10u; C025-030X050
C11: 250u; C025-030X050
C12: 50n; C025-030X050
C13, C21, C22, C24, C25, C26, C27, C28: 10n; 0603-CAP
JP1: 0; JP8Q
JP1*, JP2*, JP3, JP5*, JP6*, JP7*, JP8*, JP9*: 0; JP1
JP2: 0; JP2Q
JP5: 0; JP2
POT1, POT2, POT3: 0; JP1
PROG.JMP: 0; JP2Q
R1, R20: 330; 0603-RES
R2, R3, R4, R5, R6, R8, R18: 100k; 0603-RES
R7, R9, R17, R21, R22, R23, R34, R35, R36, R37, R38, R41, R42, R43, R44, R45, R46, R47, R48, R49, R50: 1k; 0603-RES
R19: 100; 0603-RES
R24: 1.2k; 0204V
R25: 10k; 0603-RES
R26: 10; 0204V
SV1: 0; MA03-2
SW1: RESET_BUTTON
TP1, TP2, TP10, TP11, TP12, TP13, TP14, TP15, TP16, TP17, TP18, TP19, TP20, TP22, TP23, TP24, TP25, TP26: PTR1B2,54; B2,54
U1: ATMEGA328P; TQFP32-08
U2: ZLDO1117; SOT223
U3: LM386; DIP08
U4: LT1013; SO08
U$1: SPEAKER; JP1
U$7: POWER_SWITCH; JP1
U$8: 9VOLTBATTERY; JP1

Connections:
+5V: C2.1, C3.1, C4.1, JP2.3 (1), JP2.4 (2), POT1.1, POT2.1, POT3.1, R5.2, R19.2, R25.2, R34.2, R36.2, R38.2, R42.2, R44.2, R46.2, R48.2, R50.2, SV1.5, U1.4 (VCC), U1.6 (VCC), U2.2 (OUT), U2.4 (OUT)
+9V: JP2.1, JP2.2, JP2*.1, U3.6 (V+), U$7.1, U$8.1 (+)
A0: POT1.2, TP11.TP, U1.25 (PC2(ADC2))
A1: POT2.2, TP12.TP, U1.24 (PC1(ADC1))
A2: POT3.2, TP16.TP, U1.23 (PC0(ADC0))
D0: C22.2, R37.1, TP20.TP, U1.30 (PD0(RXD))
D1: C13.2, R17.1, TP10.TP, U1.31 (PD1(TXD))
D2: C21.2, R35.1, TP15.TP, U1.32 (PD2(INT0))
D3: C24.2, R41.1, TP22.TP, U1.1 (PD3(INT1))
D4: C27.2, R47.1, TP25.TP, U1.2 (PD4(XCK/T0))
D5: C25.2, R43.1, TP23.TP, U1.26 (PC3(ADC3))
D6: C26.2, R45.1, TP24.TP, U1.27 (PC4(ADC4/SDA))
D7: C28.2, R49.1, TP26.TP, U1.28 (PC5(ADC5/SCL))
GND: C1.2, C2.2, C3.2, C4.2, C5.2, C6.2, C7.2, C8.2, C9.2, C12.2, C13.1, C21.1, C22.1, C24.1, C25.1, C26.1, C27.1, C28.1, JP1.1, JP1.3 (1), JP1.5 (1), JP1.7 (1), JP1.9 (1), JP1.11 (1), JP1.13 (1), JP1.15 (1), JP1*.2, JP3.1, JP3.2, JP5.1, R8.2, R9.1, R20.1, R21.1, R22.1, R23.1, SV1.2, SW1.1, SW1.2, U1.3 (GND), U1.5 (GND), U1.21 (AGND), U3.2 (-IN), U3.4 (V-), U4.3 (+INB), U4.4 (-INB), U4.5 (OUTB), U$1.2 (SPKR-), U$8.2 (-)
MISO: SV1.1, U1.16 (PB4(MISO))
MOSI: PROG.JMP.1, SV1.4
unnamed: C7.1, U1.20 (AREF)
unnamed: JP1.8 (2), R41.2, R42.1
unnamed: JP1.12 (2), R43.2, R44.1
unnamed: R1.1, U1.29 (PC6(/RESET))
unnamed: 20MHZ.1, C5.1, U1.7 (PB6(XTAL1/TOSC1))
unnamed: 20MHZ.2, C6.1, U1.8 (PB7(XTAL2/TOSC2))
unnamed: C8.1, R5.1, U1.18 (AVCC)
unnamed: R21.2, U1.22 (ADC7)
unnamed: R22.2, U1.19 (ADC6)
unnamed: JP1.6 (2), R35.2, R36.1
unnamed: R7.1, R8.1, U4.8 (-INA)
unnamed: R9.2, U1.12 (PB0(ICP))
unnamed: JP5*.2, R6.2
unnamed: JP9*.2, R4.2
unnamed: R1.2, SW1.3, SW1.4
unnamed: JP1.4 (2), R17.2, R34.1
unnamed: JP8*.2, R18.2
unnamed: C10.1, R24.2
unnamed: C11.2, TP2.TP, U$1.1 (SPKR+)
unnamed: JP7*.2, R2.2
unnamed: JP2*.2, U4.6 (V+)
unnamed: JP5.3, R7.2, U4.7 (OUTA)
unnamed: R19.1, R20.2, U2.1 (ADJ)
unnamed: C1.1, U2.3 (IN), U$7.2
unnamed: JP6*.2, R3.2
unnamed: R24.1, U3.1 (GAIN)
unnamed: C10.2, U3.8 (GAIN)
unnamed: JP1.2, R37.2, R38.1
unnamed: JP5.2, U3.3 (+IN)
unnamed: C9.1, U3.7 (BP)
unnamed: C11.1, R26.2, U3.5 (OUT)
unnamed: C12.1, R26.1
unnamed: JP1.14 (2), R45.2, R46.1
unnamed: JP1.10 (2), R47.2, R48.1
unnamed: JP1.16 (2), R49.2, R50.1
PB0: JP5*.1, TP13.TP, U1.13 (PB1(OC1A))
PB1: JP6*.1, TP14.TP, U1.14 (PB2(SS/OC1B))
PB2: JP7*.1, PROG.JMP.3, TP17.TP
PB3: JP8*.1, TP18.TP, U1.9 (PD5(T1))
PB3/MOSI: PROG.JMP.2, PROG.JMP.4, U1.15 (PB3(MOSI/OC2))
PB4: JP9*.1, TP19.TP, U1.10 (PD6(AIN0))
PD7: R23.2, U1.11 (PD7(AIN1))
RESET: R25.1, SV1.3
SCK: SV1.6, U1.17 (PB5(SCK))
SUMS: R2.1, R3.1, R4.1, R6.1, R18.1, TP1.TP, U4.1 (+INA)
V-: JP1*.1, U4.2 (V-)

Notes on the sheet:
Power Switch
Programming Header
Digital Inputs
Power Supply
Microcontroller
Summing and Amplification Stage
Analog Inputs
LP filter
*Add jumper for default operation
5V Header
9V Header
GND Header
Fc = 16Hz
Jumpers to allow for alternate tone generation scheme
Programming mode
Normal Operation mode
Team Members
Version 5.1
11/9/2014

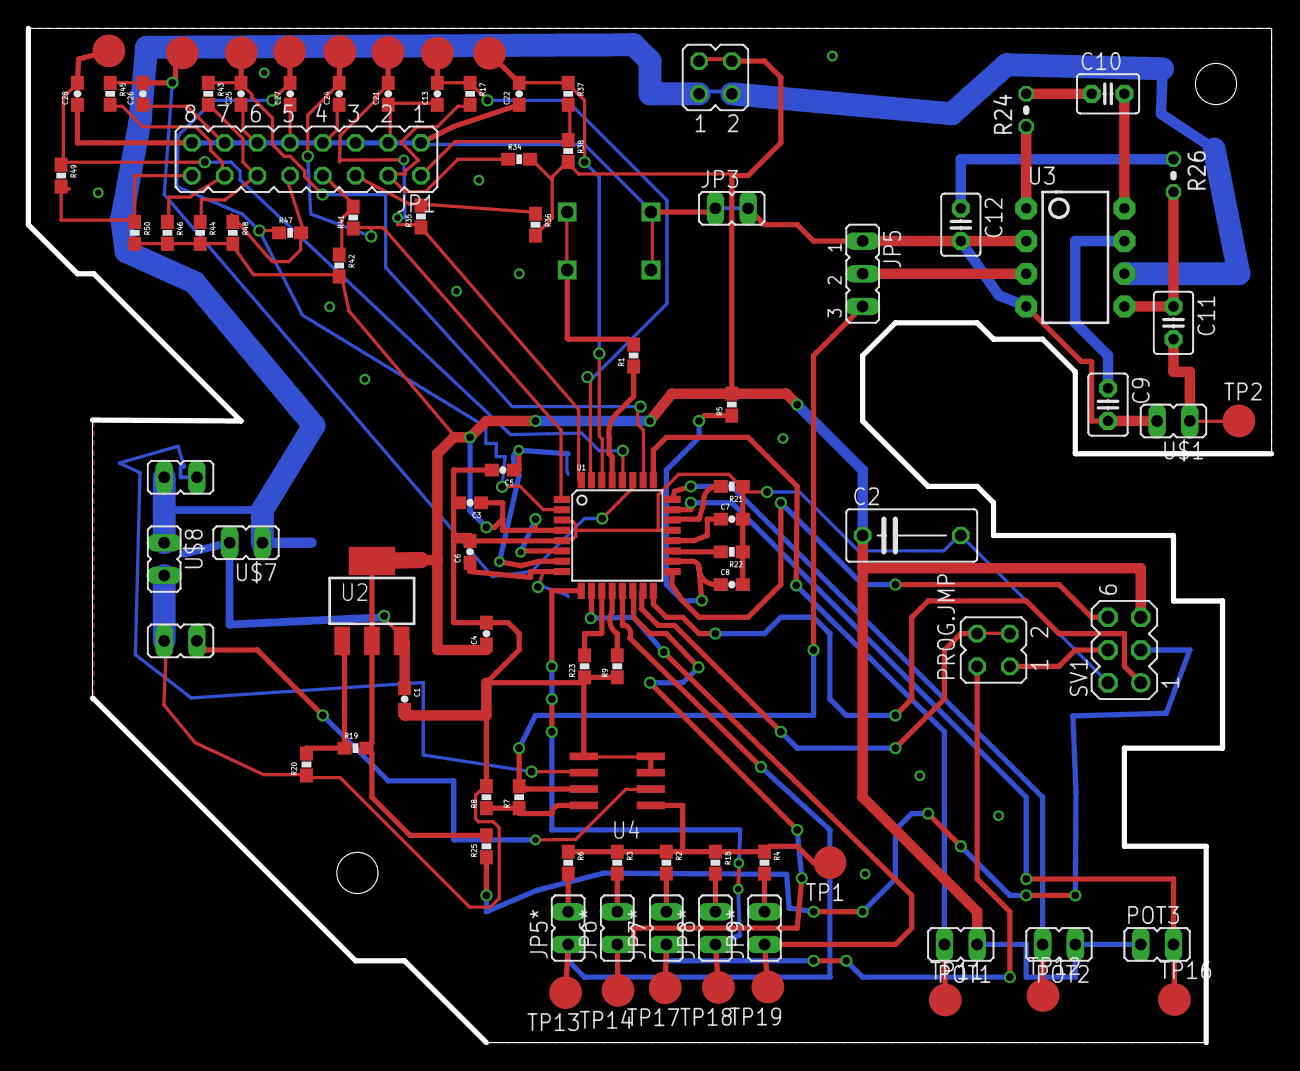
[picture p119: board T01_Synth_Glove_Final.brd from above]

Board: 2 copper layers, 96.5 x 78.7 mm, 97 parts (1 on the bottom side), 62 nets.
