Debrant/great_411_practicum/eagle/Old Revisions/T01_Synth_Glove_v5.brd

## EAGLE design eagle/Old Revisions/T01_Synth_Glove_v5.brd (2014-11-08, an earlier design)

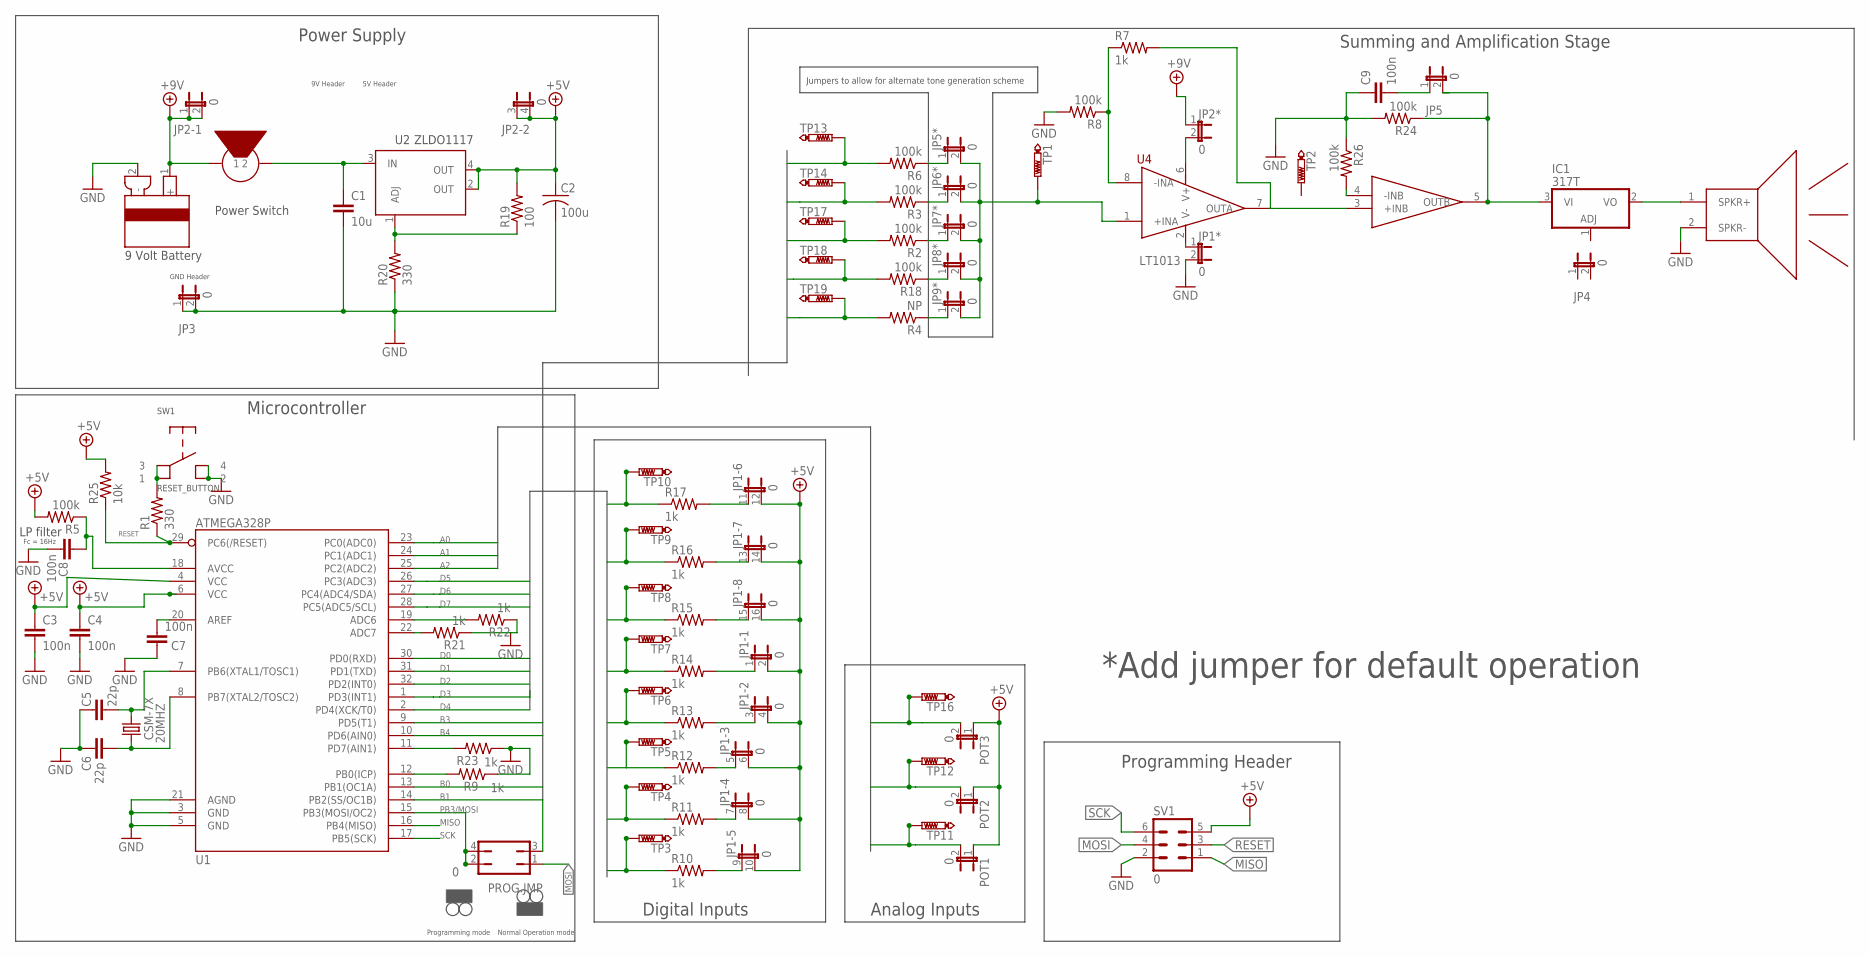
[picture p120: schematic T01_Synth_Glove_v5.sch]

Parts:
20MHZ: CSM-7X; CSM-7X-DU
C1: 10u; 0603-CAP
C2: 100u; C075-042X103
C3, C4, C7, C8, C9: 100n; 0603-CAP
C5, C6: 22p; 0603-CAP
IC1: 317T; TO220H
JP1: 0; JP8Q
JP1*, JP2*, JP3, JP4, JP5, JP5*, JP6*, JP7*, JP8*, JP9*: 0; JP1
JP2: 0; JP2Q
POT1, POT2, POT3: 0; JP1
PROG.JMP: 0; JP2Q
R1, R20: 330; 0603-RES
R2, R3, R5, R6, R8, R18, R24, R26: 100k; 0603-RES
R4: NP; 0603-RES
R7, R9, R10, R11, R12, R13, R14, R15, R16, R17, R21, R22, R23: 1k; 0603-RES
R19: 100; 0603-RES
R25: 10k; 0603-RES
SV1: 0; MA03-2
SW1: RESET_BUTTON
TP1, TP2, TP3, TP4, TP5, TP6, TP7, TP8, TP9, TP10, TP11, TP12, TP13, TP14, TP16, TP17, TP18, TP19: PTR1B2,54; B2,54
U1: ATMEGA328P; TQFP32-08
U2: ZLDO1117; SOT223
U4: LT1013; SO08
U$1: SPEAKER; JP1
U$7: POWER_SWITCH; JP1
U$8: 9VOLTBATTERY; JP1

Connections:
+5V: C2.1, C3.1, C4.1, JP1.2, JP1.4 (2), JP1.6 (2), JP1.8 (2), JP1.10 (2), JP1.12 (2), JP1.14 (2), JP1.16 (2), JP2.3 (1), JP2.4 (2), POT1.1, POT2.1, POT3.1, R5.2, R19.2, R25.2, SV1.5, U1.4 (VCC), U1.6 (VCC), U2.2 (OUT), U2.4 (OUT)
+9V: JP2.1, JP2.2, JP2*.1, U$7.1, U$8.1 (+)
A0: POT1.2, TP11.TP, U1.23 (PC0(ADC0))
A1: POT2.2, TP12.TP, U1.24 (PC1(ADC1))
A2: POT3.2, TP16.TP, U1.25 (PC2(ADC2))
B0: R6.2, TP13.TP, U1.13 (PB1(OC1A))
B1: R2.2, R3.2, TP14.TP, TP17.TP, U1.14 (PB2(SS/OC1B))
B2: PROG.JMP.3
B3: R18.2, TP18.TP, U1.9 (PD5(T1))
B4: R4.2, TP19.TP, U1.10 (PD6(AIN0))
D0: R10.1, TP3.TP, U1.30 (PD0(RXD))
D1: R11.1, TP4.TP, U1.31 (PD1(TXD))
D2: R12.1, TP5.TP, U1.32 (PD2(INT0))
D3: R13.1, TP6.TP, U1.1 (PD3(INT1))
D4: R14.1, TP7.TP, U1.2 (PD4(XCK/T0))
D5: R15.1, TP8.TP, U1.26 (PC3(ADC3))
D6: R16.1, TP9.TP, U1.27 (PC4(ADC4/SDA))
D7: R17.1, TP10.TP, U1.28 (PC5(ADC5/SCL))
GND: C1.2, C2.2, C3.2, C4.2, C5.2, C6.2, C7.2, C8.2, C9.1, JP1*.2, JP3.1, JP3.2, R8.2, R9.1, R20.1, R21.1, R22.1, R23.1, R24.2, R26.1, SV1.2, SW1.2, SW1.4, U1.3 (GND), U1.5 (GND), U1.21 (AGND), U$1.2 (SPKR-), U$8.2 (-)
MISO: SV1.1, U1.16 (PB4(MISO))
MOSI: PROG.JMP.1, SV1.4
unnamed: C7.1, U1.20 (AREF)
unnamed: JP5*.2, JP6*.2, JP7*.2, JP8*.2, JP9*.2, TP1.TP, U4.1 (+INA)
unnamed: JP1.9 (1), R10.2
unnamed: JP1.7 (1), R11.2
unnamed: JP1.5 (1), R12.2
unnamed: 20MHZ.1, C5.1, U1.7 (PB6(XTAL1/TOSC1))
unnamed: 20MHZ.2, C6.1, U1.8 (PB7(XTAL2/TOSC2))
unnamed: C8.1, R5.1, U1.18 (AVCC)
unnamed: R21.2, U1.22 (ADC7)
unnamed: R22.2, U1.19 (ADC6)
unnamed: JP1.3 (1), R13.2
unnamed: JP1.1, R14.2
unnamed: JP1.15 (1), R15.2
unnamed: JP1.13 (1), R16.2
unnamed: R7.1, R8.1, U4.8 (-INA)
unnamed: R9.2, U1.12 (PB0(ICP))
unnamed: JP5*.1, R6.1
unnamed: JP6*.1, R3.1
unnamed: R1.2, SW1.1, SW1.3
unnamed: JP1.11 (1), R17.2
unnamed: JP7*.1, R2.1
unnamed: R26.2, U4.4 (-INB)
unnamed: JP8*.1, R18.1
unnamed: IC1.2 (VO), U$1.1 (SPKR+)
unnamed: JP9*.1, R4.1
unnamed: JP2*.2, U4.6 (V+)
unnamed: R7.2, U4.7 (OUTA)
unnamed: R19.1, R20.2, U2.1 (ADJ)
unnamed: C1.1, U2.3 (IN), U$7.2
unnamed: C9.2, JP5.1
unnamed: IC1.3 (VI), JP5.2, R24.1, U4.5 (OUTB)
PB3/MOSI: PROG.JMP.2, PROG.JMP.4, U1.15 (PB3(MOSI/OC2))
PD7: R23.2, U1.11 (PD7(AIN1))
RESET: R1.1, R25.1, SV1.3, U1.29 (PC6(/RESET))
SCK: SV1.6, U1.17 (PB5(SCK))
V-: JP1*.1, U4.2 (V-)

Notes on the sheet:
Power Switch
Programming Header
Digital Inputs
Power Supply
Microcontroller
Summing and Amplification Stage
Analog Inputs
LP filter
*Add jumper for default operation
5V Header
9V Header
GND Header
Fc = 16Hz
Jumpers to allow for alternate tone generation scheme
Programming mode
Normal Operation mode

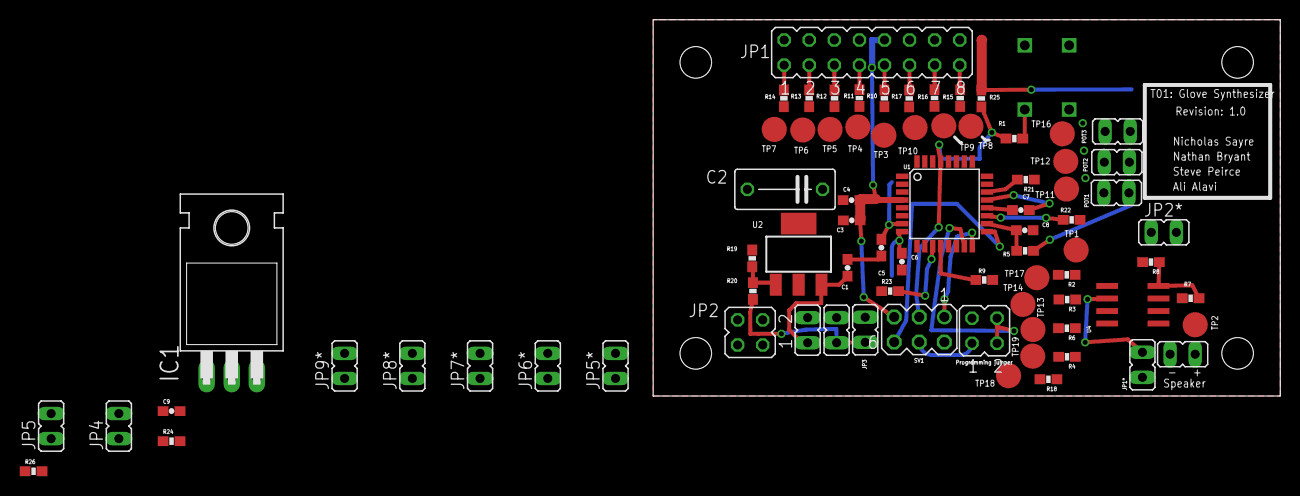
[picture p121: board T01_Synth_Glove_v5.brd from above]

Board: 2 copper layers, 63.5 x 38.1 mm, 79 parts (1 on the bottom side), 56 nets.
