Debrant/great_411_practicum/eagle/Prototype Board/T01_Synth_Glove_Prototype_Board.brd

## EAGLE design eagle/Prototype Board/T01_Synth_Glove_Prototype_Board.brd (2014-11-08)

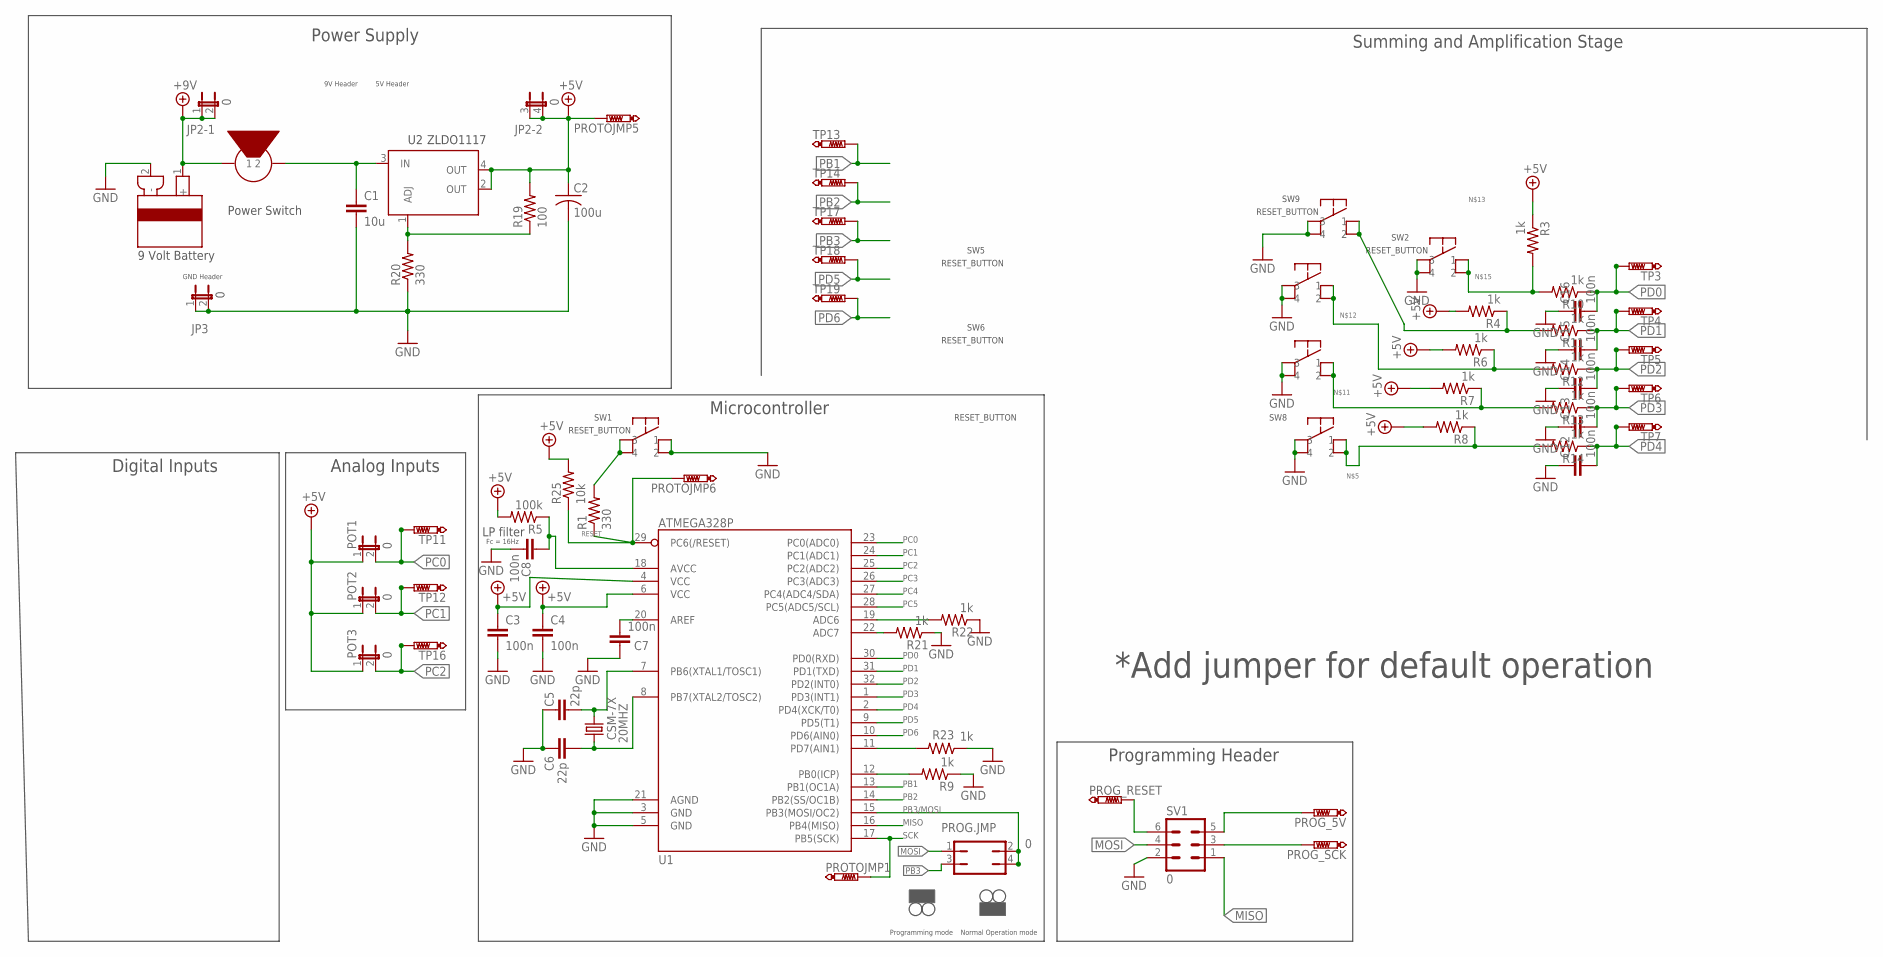
[picture p122: schematic T01_Synth_Glove_Prototype_Board.sch]

Parts:
20MHZ: CSM-7X; CSM-7X-DU
C1: 10u; 0603-CAP
C2: 100u; C075-042X103
C3, C4, C7, C8, C12, C13, C14, C15, C16: 100n; 0603-CAP
C5, C6: 22p; 0603-CAP
JP2: 0; JP2Q
JP3: 0; JP1
POT1, POT2, POT3: 0; JP1
PROG.JMP: 0; JP2Q
PROG_5V: PTR1B2,54; B2,54
PROG_RESET: PTR1B2,54; B2,54
PROG_SCK: PTR1B2,54; B2,54
PROTOJMP1, PROTOJMP5, PROTOJMP6: PTR1B2,54; B2,54
R1, R20: 330; 0603-RES
R3, R4, R6, R7, R8, R9, R10, R11, R12, R13, R14, R21, R22, R23: 1k; 0603-RES
R5: 100k; 0603-RES
R19: 100; 0603-RES
R25: 10k; 0603-RES
SV1: 0; MA03-2
SW1, SW2, SW5, SW6, SW8, SW9: RESET_BUTTON
TP3, TP4, TP5, TP6, TP7, TP11, TP12, TP13, TP14, TP16, TP17, TP18, TP19: PTR1B2,54; B2,54
U1: ATMEGA328P; TQFP32-08
U2: ZLDO1117; SOT223
U$7: POWER_SWITCH; JP1
U$8: 9VOLTBATTERY; JP1

Connections:
+5V: C2.1, C3.1, C4.1, JP2.3 (1), JP2.4 (2), POT1.1, POT2.1, POT3.1, PROTOJMP5.TP, R3.1, R4.2, R5.2, R6.2, R7.2, R8.2, R19.2, R25.2, U1.4 (VCC), U1.6 (VCC), U2.2 (OUT), U2.4 (OUT)
+9V: JP2.1, JP2.2, U$7.1, U$8.1 (+)
GND: C1.2, C2.2, C3.2, C4.2, C5.2, C6.2, C7.2, C8.2, C12.1, C13.1, C14.1, C15.1, C16.1, JP3.1, JP3.2, R9.1, R20.1, R21.1, R22.1, R23.1, SV1.2, SW1.1, SW1.2, SW2.3, SW2.4, SW5.3, SW5.4, SW6.3, SW6.4, SW8.3, SW8.4, SW9.3, SW9.4, U1.3 (GND), U1.5 (GND), U1.21 (AGND), U$8.2 (-)
JP3: PROG_SCK.TP, SV1.3
MISO: SV1.1, U1.16 (PB4(MISO))
MOSI: PROG.JMP.1, SV1.4
unnamed: C7.1, U1.20 (AREF)
unnamed: PROG_5V.TP, SV1.5
unnamed: R8.1, R14.2, SW8.1, SW8.2
unnamed: 20MHZ.1, C5.1, U1.7 (PB6(XTAL1/TOSC1))
unnamed: 20MHZ.2, C6.1, U1.8 (PB7(XTAL2/TOSC2))
unnamed: C8.1, R5.1, U1.18 (AVCC)
unnamed: R21.2, U1.22 (ADC7)
unnamed: R22.2, U1.19 (ADC6)
unnamed: R7.1, R13.2, SW6.1, SW6.2
unnamed: R6.1, R12.2, SW5.1, SW5.2
unnamed: R4.1, R11.2, SW9.1, SW9.2
unnamed: R3.2, R10.2, SW2.1, SW2.2
unnamed: R9.2, U1.12 (PB0(ICP))
unnamed: R1.2, SW1.3, SW1.4
unnamed: R19.1, R20.2, U2.1 (ADJ)
unnamed: C1.1, U2.3 (IN), U$7.2
PB1: TP13.TP, U1.13 (PB1(OC1A))
PB2: TP14.TP, U1.14 (PB2(SS/OC1B))
PB3: PROG.JMP.3, TP17.TP
PB3/MOSI: PROG.JMP.2, PROG.JMP.4, U1.15 (PB3(MOSI/OC2))
PC0: POT1.2, TP11.TP, U1.23 (PC0(ADC0))
PC1: POT2.2, TP12.TP, U1.24 (PC1(ADC1))
PC2: POT3.2, TP16.TP, U1.25 (PC2(ADC2))
PC3: U1.26 (PC3(ADC3))
PC4: U1.27 (PC4(ADC4/SDA))
PC5: U1.28 (PC5(ADC5/SCL))
PD0: C16.2, R10.1, TP3.TP, U1.30 (PD0(RXD))
PD1: C15.2, R11.1, TP4.TP, U1.31 (PD1(TXD))
PD2: C14.2, R12.1, TP5.TP, U1.32 (PD2(INT0))
PD3: C13.2, R13.1, TP6.TP, U1.1 (PD3(INT1))
PD4: C12.2, R14.1, TP7.TP, U1.2 (PD4(XCK/T0))
PD5: TP18.TP, U1.9 (PD5(T1))
PD6: TP19.TP, U1.10 (PD6(AIN0))
PD7: R23.2, U1.11 (PD7(AIN1))
PJ4: PROG_RESET.TP, SV1.6
RESET: PROTOJMP6.TP, R1.1, R25.1, U1.29 (PC6(/RESET))
SCK: PROTOJMP1.TP, U1.17 (PB5(SCK))

Notes on the sheet:
Power Switch
Programming Header
Digital Inputs
Power Supply
Microcontroller
Summing and Amplification Stage
Analog Inputs
LP filter
*Add jumper for default operation
5V Header
9V Header
GND Header
Fc = 16Hz
Programming mode
Normal Operation mode

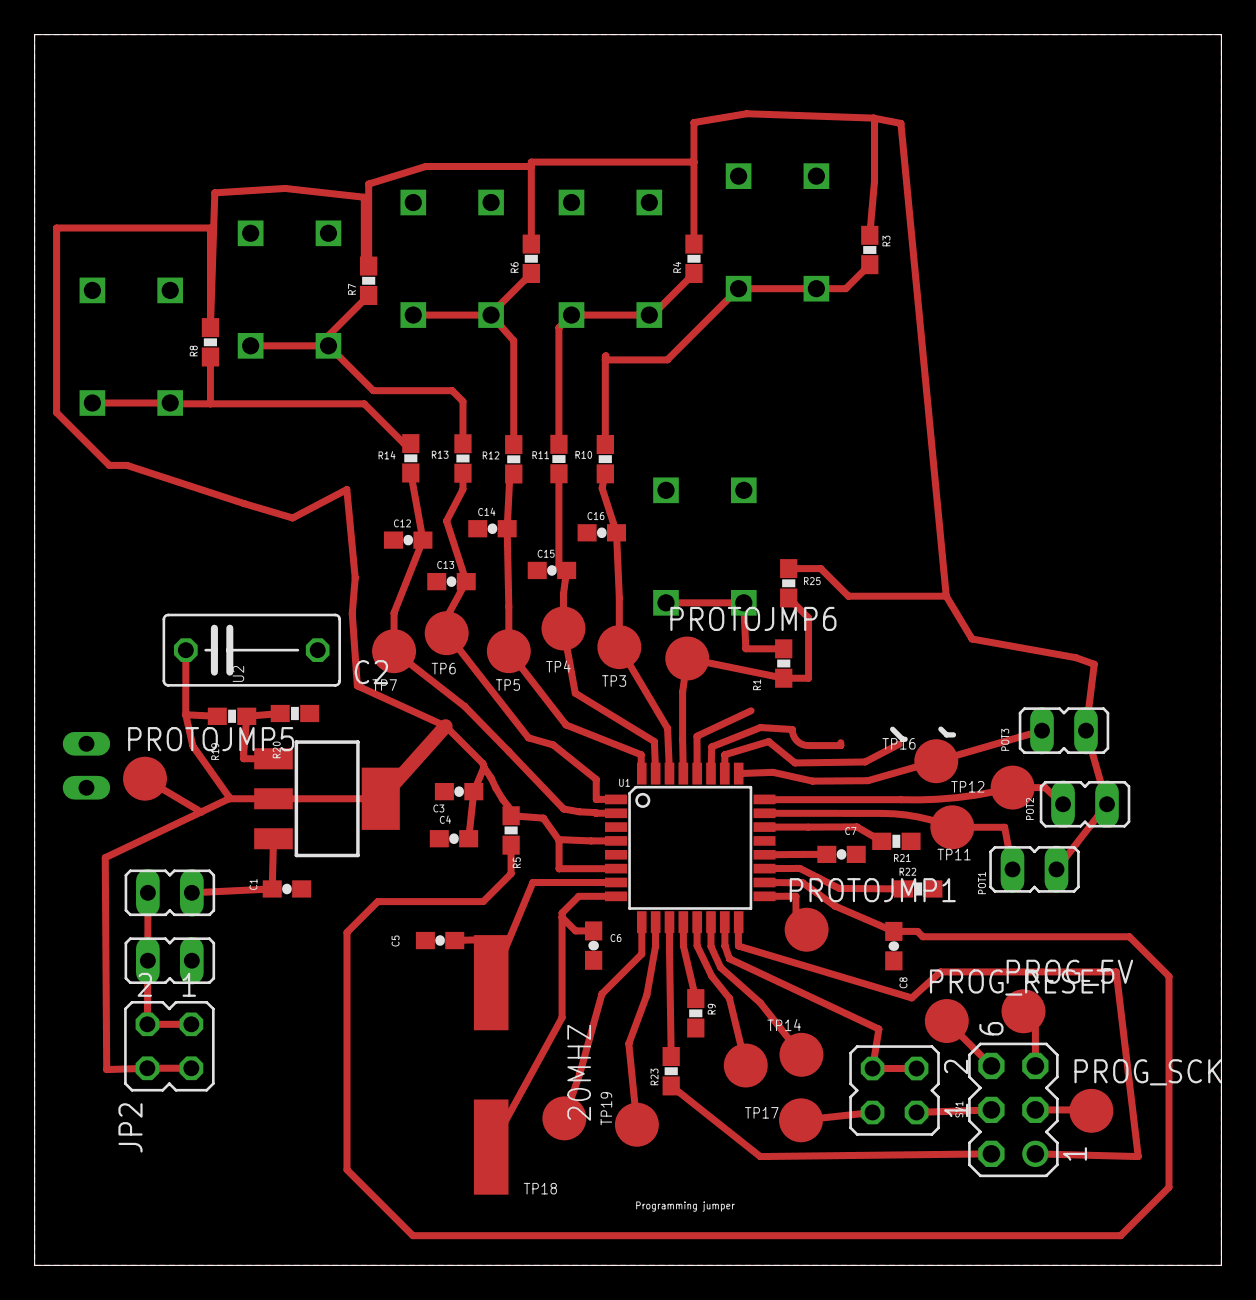
[picture p123: board T01_Synth_Glove_Prototype_Board.brd from above]

Board: 2 copper layers, 68.6 x 71.1 mm, 69 parts (1 on the bottom side), 40 nets.
