Debrant/great_411_practicum/eagle/Prototype Board/Amplifier Board/T01_Synth_Glove_Prototype_Board_Amplifier.brd

## EAGLE design eagle/Prototype Board/Amplifier Board/T01_Synth_Glove_Prototype_Board_Amplifier.brd (2014-11-08)

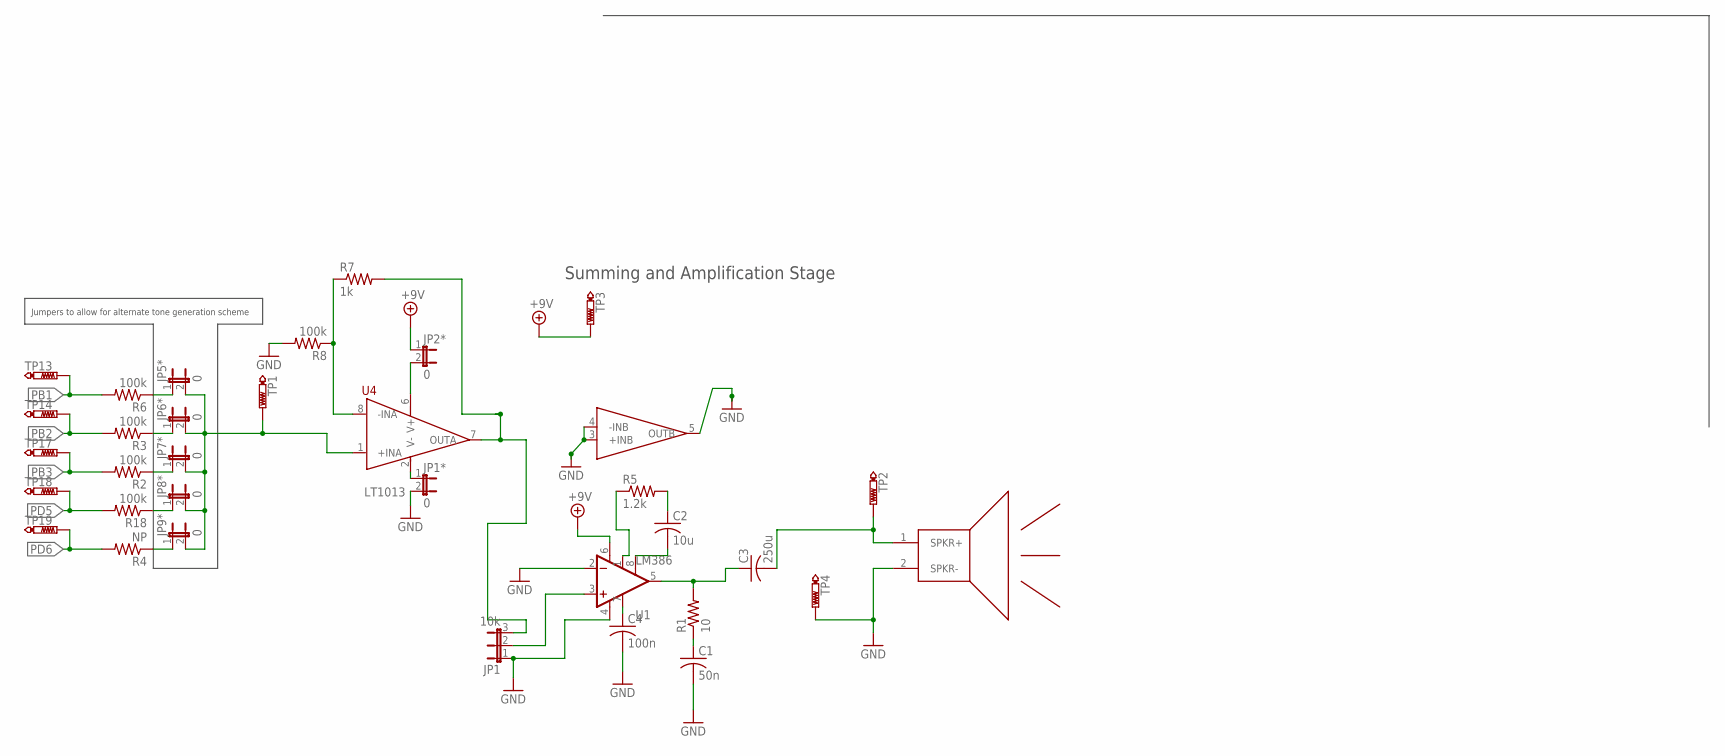
[picture p124: schematic T01_Synth_Glove_Prototype_Board_Amplifier.sch]

Parts:
C1: 50n; C025-030X050
C2: 10u; C025-030X050
C3: 250u; C025-030X050
C4: 100n; C025-030X050
JP1: 10k; JP2
JP1*, JP2*, JP5*, JP6*, JP7*, JP8*, JP9*: 0; JP1
R1: 10; 0204V
R2, R3, R6, R8, R18: 100k; 0603-RES
R4: NP; 0603-RES
R5: 1.2k; 0204V
R7: 1k; 0603-RES
TP1, TP2, TP3, TP4, TP13, TP14, TP17, TP18, TP19: PTR1B2,54; B2,54
U1: LM386; DIP08
U4: LT1013; SO08
U$1: SPEAKER; JP1

Connections:
+9V: JP2*.1, TP3.TP, U1.6 (V+)
GND: C1.2, C4.2, JP1.1, JP1*.2, R8.2, TP4.TP, U1.2 (-IN), U1.4 (V-), U4.3 (+INB), U4.4 (-INB), U4.5 (OUTB), U$1.2 (SPKR-)
unnamed: C3.1, R1.2, U1.5 (OUT)
unnamed: JP5*.2, JP6*.2, JP7*.2, JP8*.2, JP9*.2, TP1.TP, U4.1 (+INA)
unnamed: JP1.3, R7.2, U4.7 (OUTA)
unnamed: C1.1, R1.1
unnamed: C3.2, TP2.TP, U$1.1 (SPKR+)
unnamed: C2.2, U1.8 (GAIN)
unnamed: C2.1, R5.2
unnamed: R5.1, U1.1 (GAIN)
unnamed: C4.1, U1.7 (BP)
unnamed: JP1.2, U1.3 (+IN)
unnamed: R7.1, R8.1, U4.8 (-INA)
unnamed: JP5*.1, R6.1
unnamed: JP6*.1, R3.1
unnamed: JP7*.1, R2.1
unnamed: JP2*.2, U4.6 (V+)
unnamed: JP8*.1, R18.1
unnamed: JP9*.1, R4.1
PB1: R6.2, TP13.TP
PB2: R3.2, TP14.TP
PB3: R2.2, TP17.TP
PD5: R18.2, TP18.TP
PD6: R4.2, TP19.TP
V-: JP1*.1, U4.2 (V-)

Notes on the sheet:
Summing and Amplification Stage
Jumpers to allow for alternate tone generation scheme

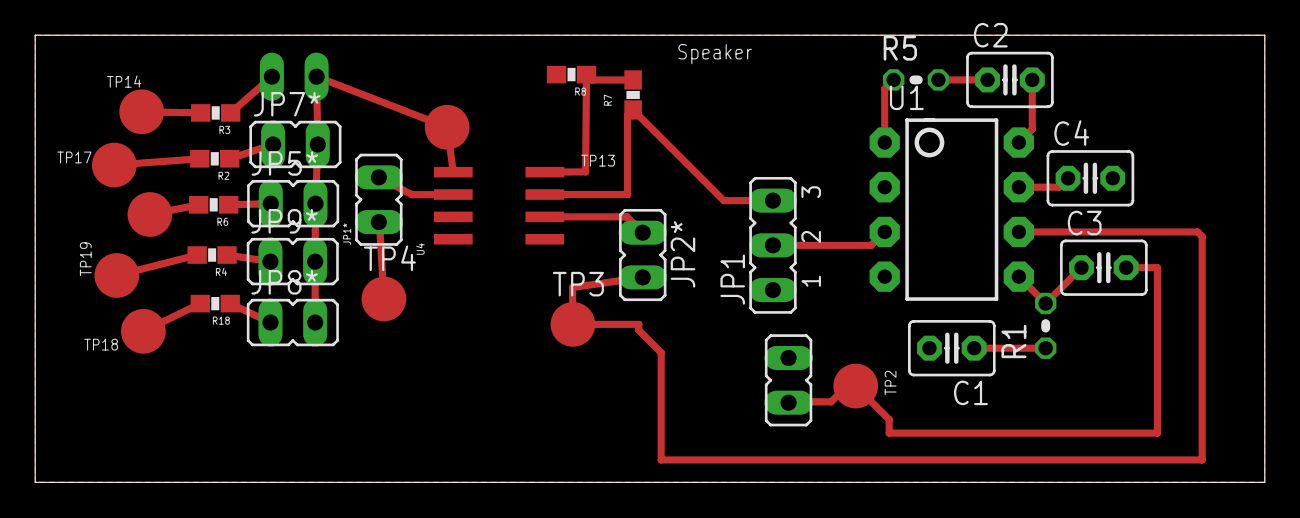
[picture p125: board T01_Synth_Glove_Prototype_Board_Amplifier.brd from above]

Board: 2 copper layers, 69.8 x 25.4 mm, 33 parts (1 on the bottom side), 25 nets.
