Debrant/great_411_practicum/(commit log)

2014-10-12 Eagle Schematic template
    [411_Synth.sch]
2014-10-18 Programmer
    Added programmer to schematic
2014-10-23 Update 23
    [411_Synth.sch]
2014-10-27 Continued work on eagle schematic + project library
2014-10-28 SWITCHED INPUT LED TEST CODE
2014-10-28 AVR Instruction Set - Syntax and Sample Code, etc.
2014-10-31 AVR CODE IMPLEMENTING INTERRUPTS TO LIGHT LED, USE PIN 4 AS INPUT!
2014-10-31 MULTIPLE INPUT, CORRESPONDING OUTPUT INTERRUPT BASED TEST PROG USE PINS: 14, 15, 16, 17, 18
2014-10-31 BACKING UP NEWEST CODE, PWM IMPLEMENTATION, BROKEN!!
    [AVR_PWM.c]
2014-11-01 added libraries
    [T01_411_Synth_v2.1.sch]
2014-11-02 WORKING interrupt based code, multiple input outputs
2014-11-02 WORKING interrupt based multi IO code
2014-11-03 ERC free schematic
    ERC free complete schematic, added new devices to the eagle library,
    more documentation
    [T01_411_Synth_v3.sch]
2014-11-05 DRC error free board, and DRU + CAM files
    [411_Synth_v3.1.brd, 411_Synth_v3.1.sch]
2014-11-05 Eagle file housekeeping
    [411_Synth.sch, 411_Synth_v2.sch, T01_411_Synth_v2.1.sch, T01_411_Synth_v3.sch, T01_Synth_Glove_v3.1.brd, T01_Synth_Glove_v3.1.sch]
2014-11-06 2 working tones, switches need debouncing, currently VERY ugly, will clean up tomorrow...er later today...
2014-11-07 Schematic update, Started Prototype Board
    [T01_Synth_Glove_Prototype_Board.brd, T01_Synth_Glove_Prototype_Board.sch, T01_Synth_Glove_v3.1.brd, T01_Synth_Glove_v3.1.sch, T01_Synth_Glove_v4.brd, T01_Synth_Glove_v4.sch]
2014-11-07 Prototype Board Amplifier Stage
    For making prototype in EPL
    [T01_Synth_Glove_Prototype_Board_Amplifier.brd, T01_Synth_Glove_Prototype_Board_Amplifier.sch]
2014-11-07 Prototype board update
2014-11-07 test board revisions
    [T01_Synth_Glove_Prototype_Board.sch]
2014-11-07 clearing deleted files
    [T01_Synth_Glove_Prototype_Board.brd]
2014-11-07 lost file return
    [T01_Synth_Glove_Prototype_Board.brd]
2014-11-07 Gerber Files for Amp Board
    [T01_Synth_Glove_Prototype_Board_Amplifier.xln]
2014-11-08 Update, more CAM files
    [T01_Synth_Glove_Prototype_Board.brd, T01_Synth_Glove_Prototype_Board.sch, T01_Synth_Glove_Prototype_Board_Amplifier.brd, T01_Synth_Glove_Prototype_Board_Amplifier.sch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]
2014-11-08 Revisions and more CAM
    [T01_Synth_Glove_Prototype_Board.brd, T01_Synth_Glove_Prototype_Board.sch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]
2014-11-08 WORKING backup, multiple buttons/tones, still NOT perfect, just a backup!
2014-11-08 issue 5 and greenberg requsts
    [T01_Synth_Glove_v5.brd, T01_Synth_Glove_v5.sch]
2014-11-09 Board revision with debounce and 386
    [T01_Synth_Glove_v5_nsayre.brd, T01_Synth_Glove_v5_nsayre.sch]
2014-11-10 2 eagle versions with mostly no errors
    [T01_Synth_Glove_v5_nathan_bigboard.brd, T01_Synth_Glove_v5_nathan_bigboard.sch, T01_Synth_Glove_v5_nsayre_revisions_late_am.brd, T01_Synth_Glove_v5_nsayre_revisions_late_am.sch]
2014-11-10 DRC FREE up to date board
    [T01_Synth_Glove_v5_nathan_bigboard_DRC_FREE.brd, T01_Synth_Glove_v5_nathan_bigboard_DRC_FREE.sch]
2014-11-10 revision to board
    [T01_Synth_Glove_v6.brd, T01_Synth_Glove_v6.sch]
2014-11-10 added mounting holes
    [T01_Synth_Glove_v6.1.brd, T01_Synth_Glove_v6.1.sch]
2014-11-10 Alternate layout
    [T01_Synth_Glove_v6.1_nsayre.brd, T01_Synth_Glove_v6.1_nsayre.sch]
2014-11-10 last minute
    [T01_Synth_Glove_v5_nathan_bigboard_DRC_freev2.brd, T01_Synth_Glove_v5_nathan_bigboard_DRC_freev2.sch]
2014-11-10 Eagle housekeeping + final board revision
    [T01_Synth_Glove_Final.brd, T01_Synth_Glove_Final.sch, T01_Synth_Glove_v4.brd, T01_Synth_Glove_v4.sch, T01_Synth_Glove_v5.brd, T01_Synth_Glove_v5.sch, T01_Synth_Glove_v5_nathan_bigboard.brd, T01_Synth_Glove_v5_nathan_bigboard.sch]
2014-11-12 Invoices
    Component and Board costs outlined
2014-11-12 Backup of current code, will be revised prior to completion
2014-11-19 Synth Glove Board info (Attention: Steve)
2014-11-22 amp fixes
    [T01_post_final_386_revise.brd, T01_post_final_386_revise.sch]
2014-11-24 CURRENT CODE, BROKEN?
2014-11-26 Updated pin list, set up to test IO, put LEDs on OUTPUTS!
2014-11-26 Extension of AVR_INTS2_rev2.c, using new pins, should work to implement PWM out, but NO ADC input
2014-11-30 final board and enclosure mods
    [T01_Synth_Glove_Final.brd]
2014-12-01 case planning
2014-12-02 case plans **please read notes in file
2014-12-05 current workingEST code, 2+ tones
2014-12-07 ADDING IN ADC INPUT, STILL BUGGY
    [AVR_PWM5.c]
2014-12-10 Best so far, multiple tones, ADC and variants
2014-12-10 Furthest code so far, ADC, Multiple tones, modifiers. added coments
2014-12-11 Prototype photos
    Photos of the completed prototype
